ChinaQMTECH/QM_XC7A100T_WUKONG_BOARD/V3/Datasheet/CH340_Windows_Driver/ReadMe.txt

Latest CH340/CH341 driver can be found here: http://www.wch-ic.com/downloads/CH341SER_EXE.html
