ChinaQMTECH/QM_XC7A100T_WUKONG_BOARD/V3/User_Manual/XC7A100T/QMTECH_Artix-7_XC7A100T_Wukong_Board_V3_User_Manual(Experiments)-V01.pdf

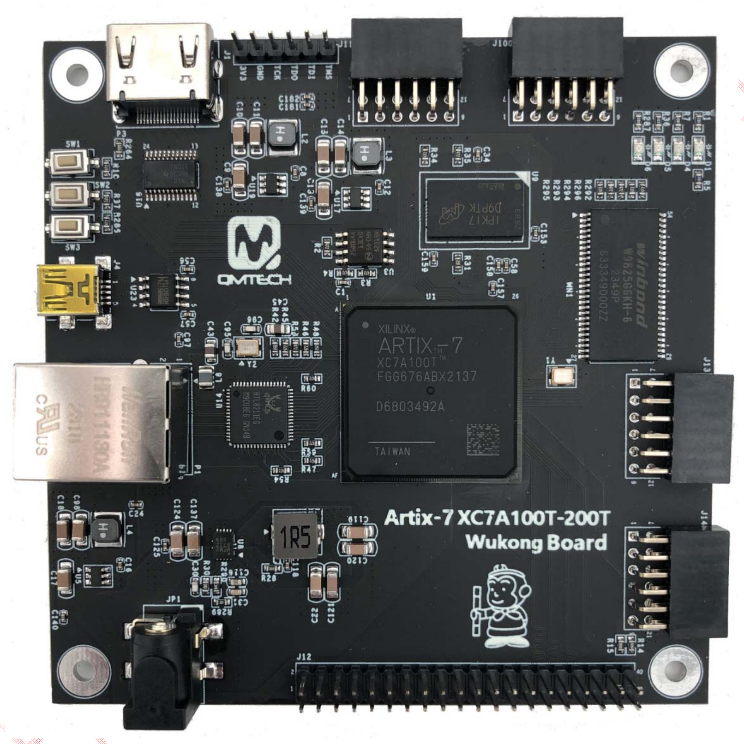
[picture p1: figure]

QMTECH Artix-7 XC7A100T Wukong Board User Manual(Experiments)

# QMTECH ARTIX-7 XC7A100T WUKONG BOARD

## USER MANUAL(EXPERIMENTS)

### Preface

The QMTech® XC7A100T Wukong Board uses Xilinx Artix®-7 devices to demonstrate the highest performance-per-watt fabric, transceiver line rates, DSP processing, and AMS integration in a cost-optimized FPGA. Featuring the MicroBlaze™ soft processor and 1,066Mb/s DDR3 support, the family is the best value for a variety of cost and power-sensitive applications including software-defined radio, machine vision cameras, and low-end wireless backhaul.

QMTECH XC7A100T Wukong Board | User Manual-V01

### Table of Contents

## 1. QMTECH XC7A100T Wukong Board Introduction

### 1.1 Wukong Board Overview

QMTECH XC7A100T Wukong board provides several user interfaces to meet different customer needs. Below section lists the detailed info of these user interfaces:
- USB to UART Serial Port, by using WCH’s CH340N chip.
- HDMI display interface, by using TI’s chip TPD12S016;
- GMII ethernet interface, by using Realtek’s RTL8211EG chip;
- Four Digilent PMOD standard compatible female headers;

### 1.2 Wukong Board Top View

Below figure shows the top view of QMTECH XC7A100T Wukong Board. The board’s dimension is 9.96mm x 9.96mm. All these functional chips’ power supply is injected from the power header, detailed connection refer to the hardware schematic.

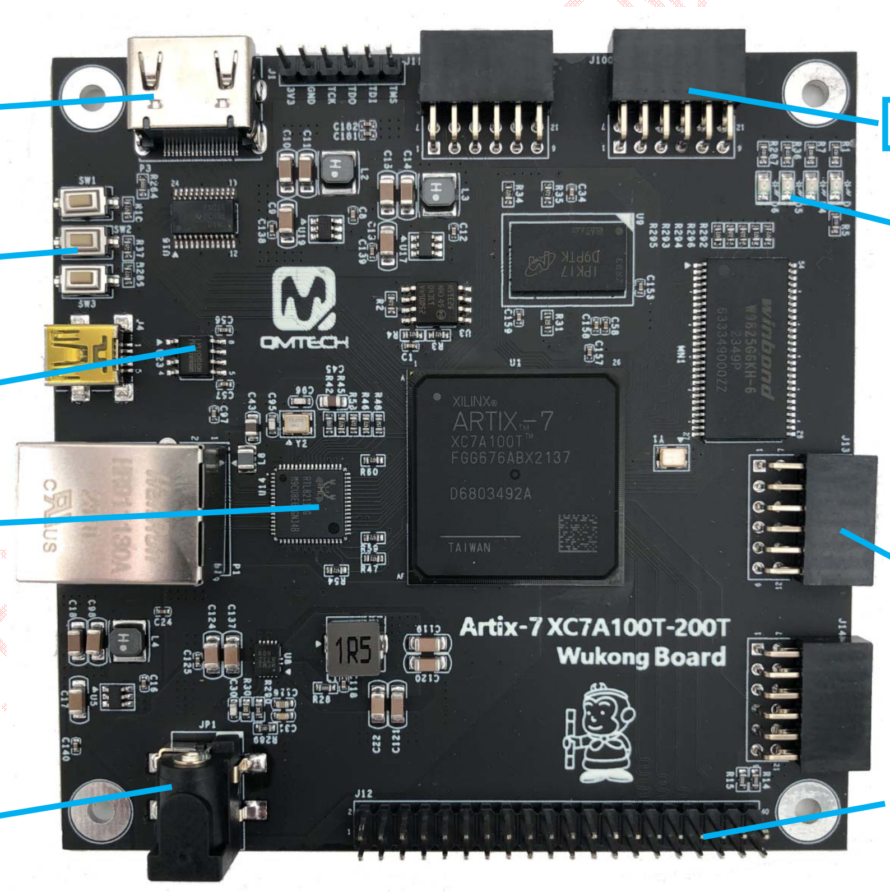
[picture p2: figure]

Figure 1-1. QMTECH XC7A100T Wukong Board

CH340N USB
to UART

HDMI
Interface

GMII
Ethernet

Power
Header

PMOD

User Keys

User IOs

PMOD

User LEDs

## 2. Experiment (1): USB to Serial Port

The CH340N is a USB 2.0 to serial port bridge chip designed by WCH. The CH340N includes a USB 2.0 full-speed function controller, USB transceiver, oscillator, UART and eliminates the need for other external USB components are required for development. Below figure shows the hardware design of CH340N on the QMTECH XC7A100T Wukong board.

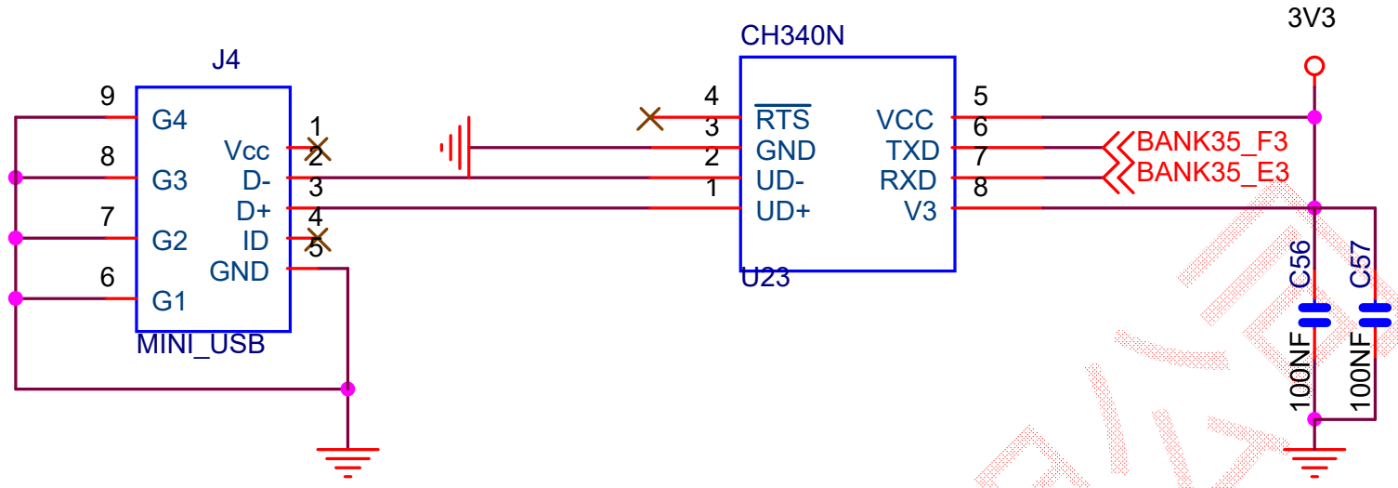
[picture p3: figure]
2 GND; 3 RTS; VCC; TXD; RXD; 3V3C⁵⁶ 100NF; BANK35_F3 BANK35_E3; MINI_USB; Vcc; GND

Figure 2-1. CH340N Hardware Design Before start to test the CH340N’s USB to UART serial communication function, make sure all the hardware connections of the development kit are correctly connected. Xilinx USB platform cable’s VREF, GND, TDI, TMS, TCK, TDO pins shall be connected to XC7A100T board’s JTAG interface. Then power on the development kit with 5V DC power source. Xilinx USB platform cable’s indicator LED’s color will turn from brown into green. At the same time, the Mini-USB cable shall also be plugged in the board, below figure shows an example hardware setup:

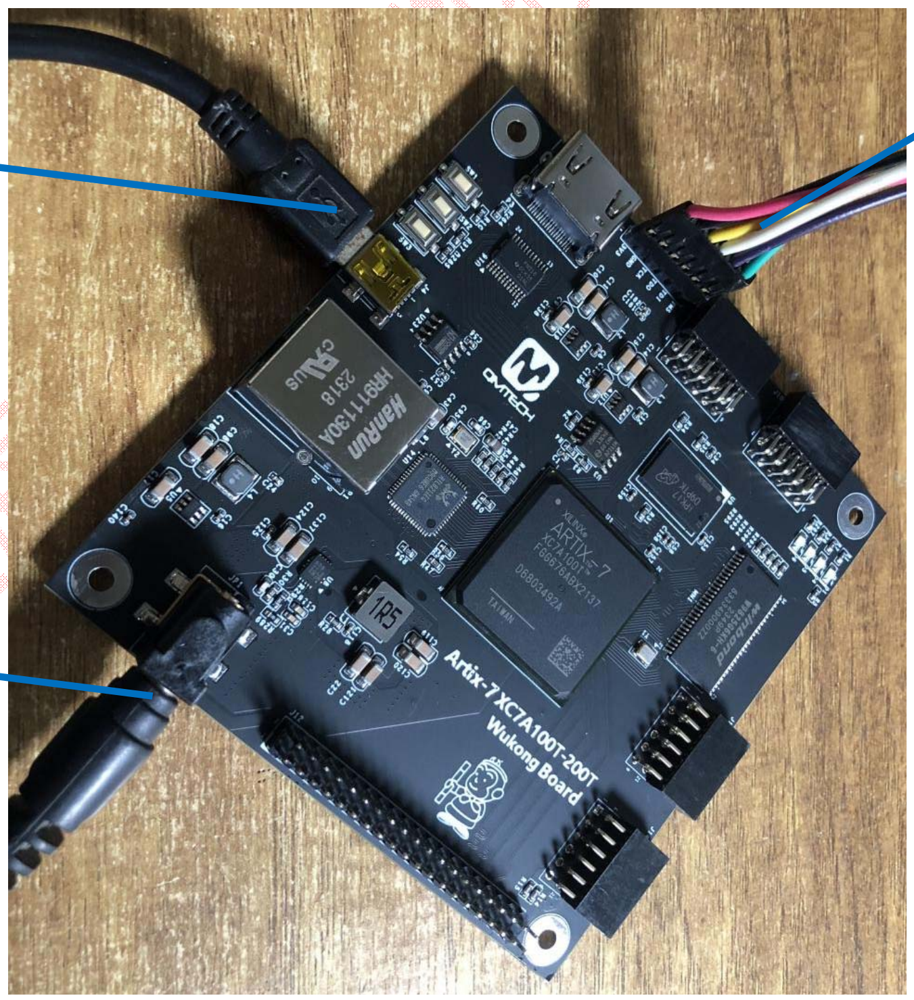
[picture p4: figure]

Mini-USB Cable

5V DC Source

JTAG Cable

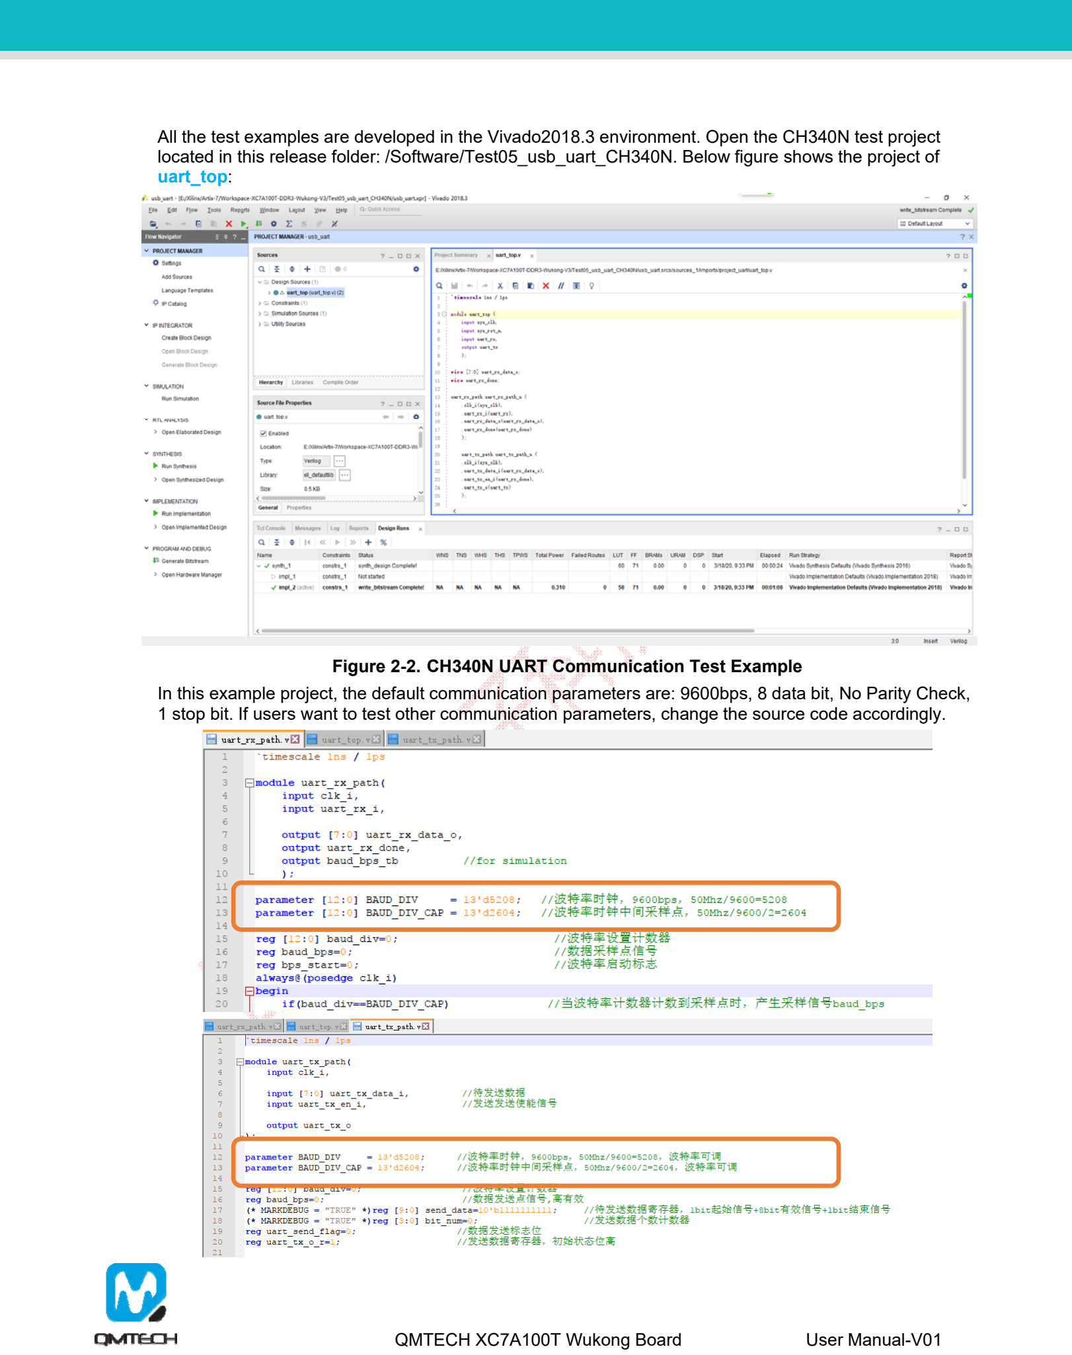
[picture p5: page 5]

All the test examples are developed in the Vivado2018.3 environment. Open the CH340N test project located in this release folder: /Software/Test05_usb_uart_CH340N. Below figure shows the project of uart_top:

Figure 2-2. CH340N UART Communication Test Example In this example project, the default communication parameters are: 9600bps, 8 data bit, No Parity Check, 1 stop bit. If users want to test other communication parameters, change the source code accordingly.

After the CH340N communication test project correctly synthesized, implemented and generated *.bit file, users could use Vivado 2018.3 program tool to program the generated *.bit file into FPGA. Below image shows the FPGA program status with program tool.

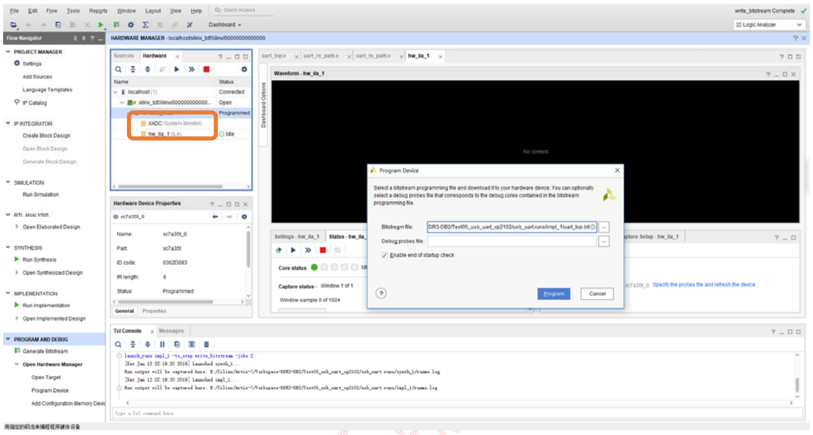
[picture p6: figure]

Figure 2-3. Program *.bit File The CH340N example test project’s main functionality is performing an UART loopback communication. The FPGA program will send the received UART data back to the PC. Below figure shows user employees some PC based UART test tool to send data to FPGA: http://www.cmsoft.cn QQ:10865600. After a short while the PC UART test tool will receive the same data stream from FPGA, which means the CH340N loopback test program is running correctly.

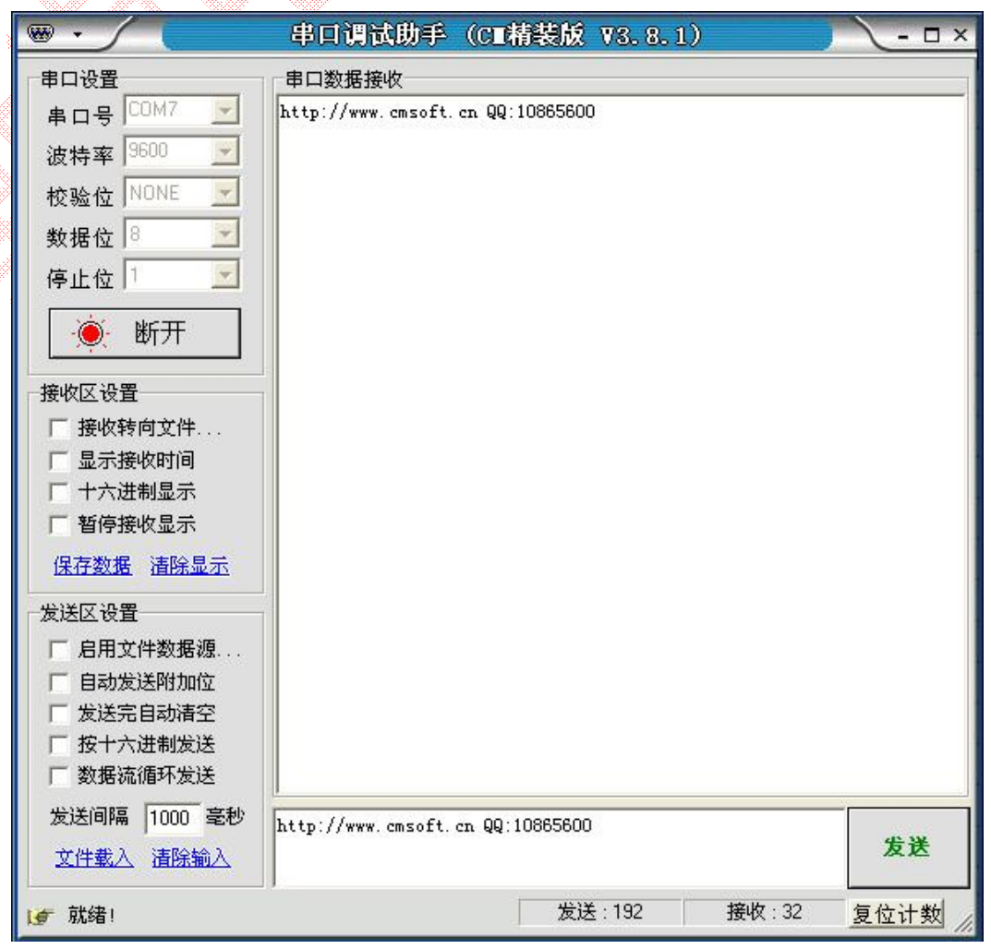
[picture p7: figure]

Figure 2-4. UART Loopback Test

## 3. Experiment (2): HDMI Displays

Transition Minimized Differential Signaling (TMDS) is used for transmitting video data over the High-Definition Multimedia Interface (HDMI). The XC7A100T Wukong Board uses TI’s TPD12S016 chip, which is a single-chip High Definition Multimedia Interface (HDMI) device with auto-direction sensing I2C voltage level shift buffers, a load switch, and integrated low capacitance high-speed electrostatic discharge (ESD) transient voltage suppression (TVS) protection diodes. Below image shows the hardware design.

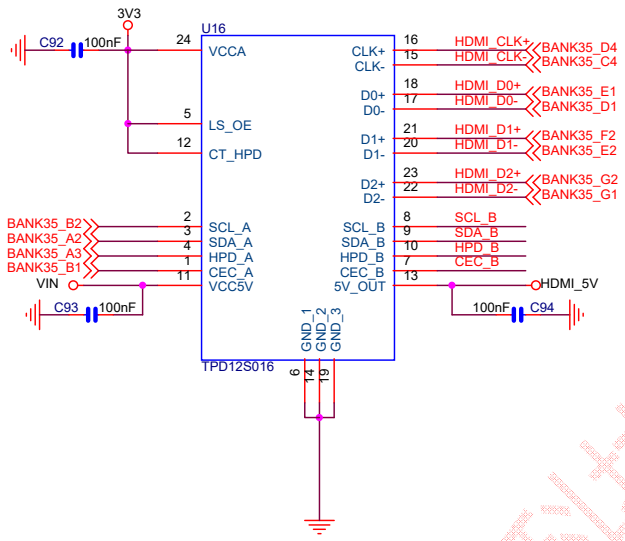
[picture p8: figure]
BANK35_A3; BANK35_A2; BANK35_B2; BANK35_B1; BANK35_C4; BANK35_D4; BANK35_E1 BANK35_D1; BANK35_F2 BANK35_E2; BANK35_G2 BANK35_G1; TPD12S016; CEC_A 1; SCL_A 2 SDA_A 3 HPD_A 4; GND_1 6; CEC_B; SCL_B; SDA_B; HPD_B; VCC5V 11; CT_HPD 12; 5V_OUT 13; GND_2; CLK-; CLK+; GND_3; VCCA 24; VIN; HPD_B CEC_B; HDMI_D1+ HDMI_D1-; HDMI_D2+ HDMI_D2-; SCL_B SDA_B; HDMI_5V; HDMI_CLK+ HDMI_CLK-; HDMI_D0+ HDMI_D0-
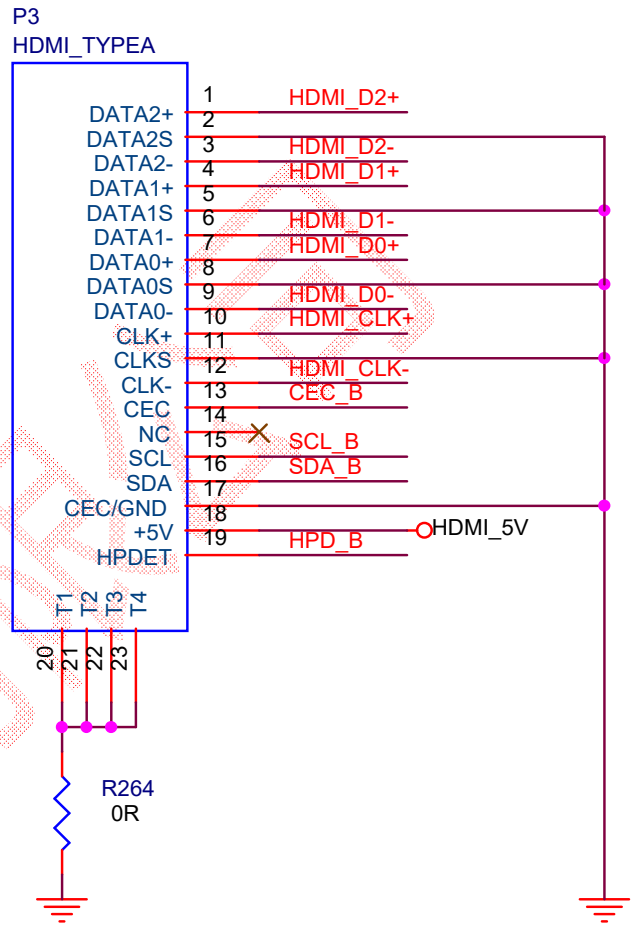
[picture p9: figure]
P3 HDMI_TYPEA; DATA2+ 1 DATA2S 2 DATA2- 3 DATA1+ 4 DATA1S 5 DATA1- 6 DATA0+ 7 DATA0S 8 DATA0- 9 CLK+ 10; CLKS; CLK-; CEC; SCL; SDA; CEC/GND; HPDET; HDMI_5V; CEC_B; SCL_B SDA_B; HPD_B; HDMI_D1- HDMI_D0+; HDMI_D0- HDMI_CLK+; HDMI_CLK-; HDMI_D2+; HDMI_D2- HDMI_D1+

Figure 3-1. HDMI Display Hardware Designs Before start to test the HDMI display function, make sure all the hardware connections of the development kit are correctly connected. Xilinx USB platform cable’s VREF, GND, TDI, TMS, TCK, TDO pins shall be connected to XC7A100T board’s JTAG interface. Then power on the development kit with 5V DC power source. Xilinx USB platform cable’s indicator LED’s color will turn from brown into green. At the same time, the HDMI cable shall also be plugged in the board, below figure shows an example hardware setup:

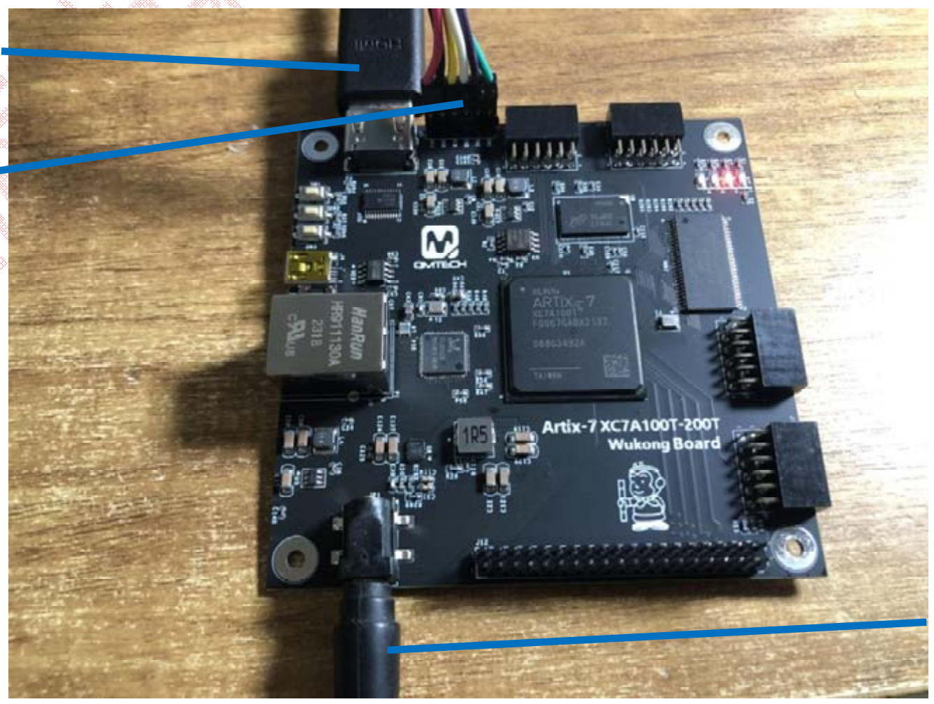
[picture p10: figure]

HDMI Cable

5V DC Source

JTAG Cable

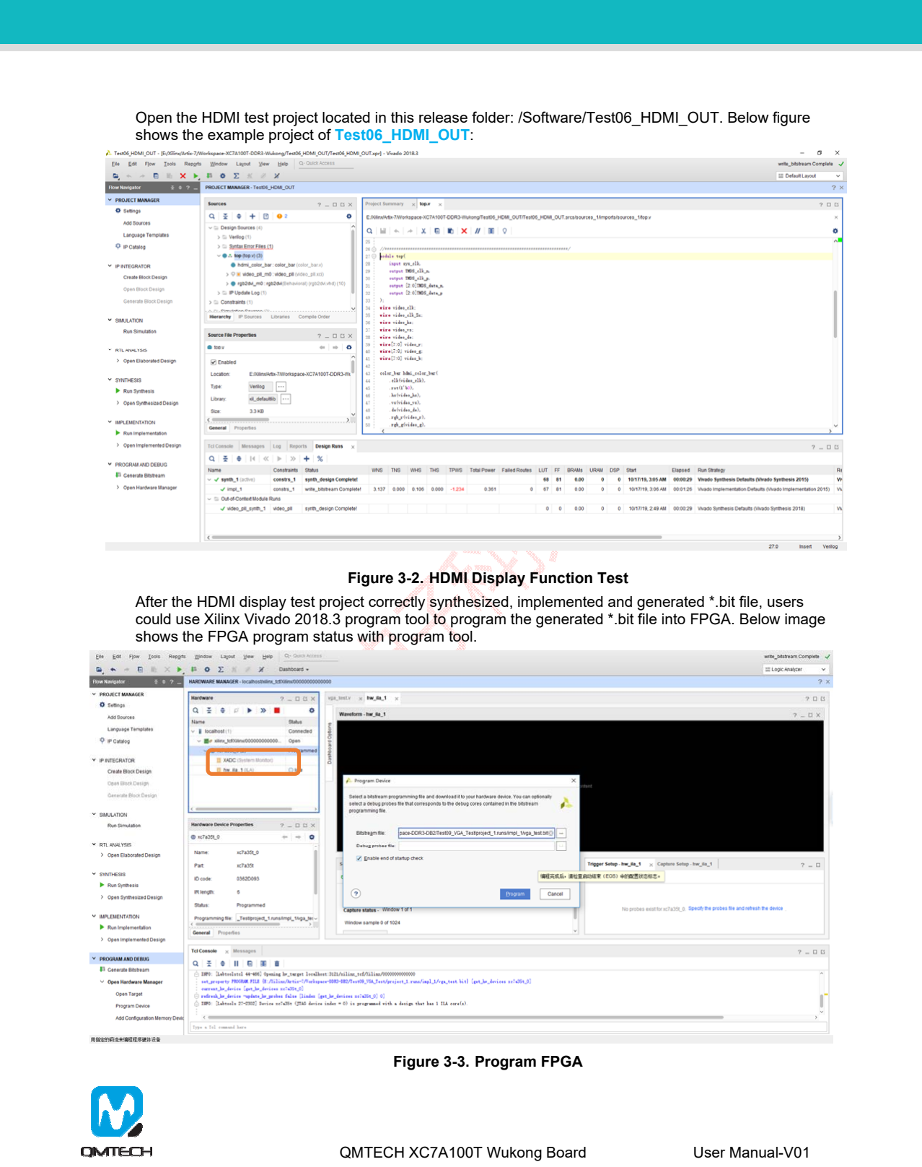
[picture p11: page 8]

Open the HDMI test project located in this release folder: /Software/Test06_HDMI_OUT. Below figure shows the example project of Test06_HDMI_OUT:

Figure 3-2. HDMI Display Function Test After the HDMI display test project correctly synthesized, implemented and generated *.bit file, users could use Xilinx Vivado 2018.3 program tool to program the generated *.bit file into FPGA. Below image shows the FPGA program status with program tool.

Figure 3-3. Program FPGA

After the FPGA correctly loaded the top.bit file, the HDMI monitor will display color bar pattern. Below image shows the example color bar pattern.

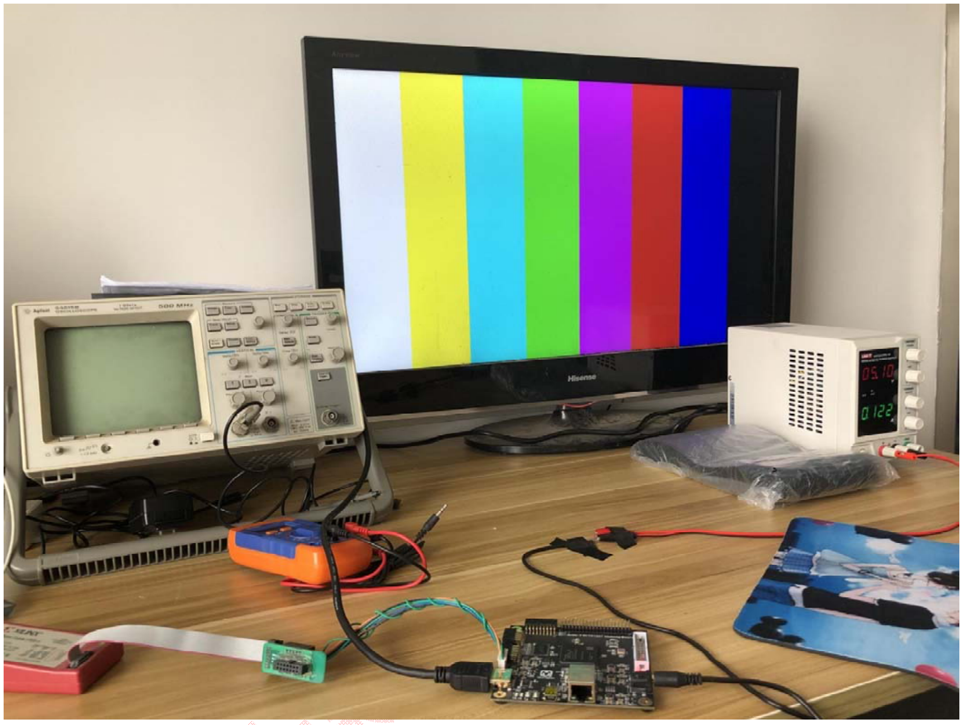
[picture p12: figure]

Figure 3-4. HDMI Display Test

## 4. Experiment (3): GMII Ethernet Test

The XC7A100T board uses RTL8211EG to implement the 10M/100M/1000M triple speed ethernet interface. It provides all the necessary physical layer functions to transmit and receive ethernet packets over the CAT.5 UTP cable. The data transfer between PHY and FPGA is via the Gigabit Media Independent Interface(GMII) for 1000Base-T. The RTL8211EG-VB chip supports 3.3V signaling for GMII interface. Below image shows the hardware design of RTL8211EG:

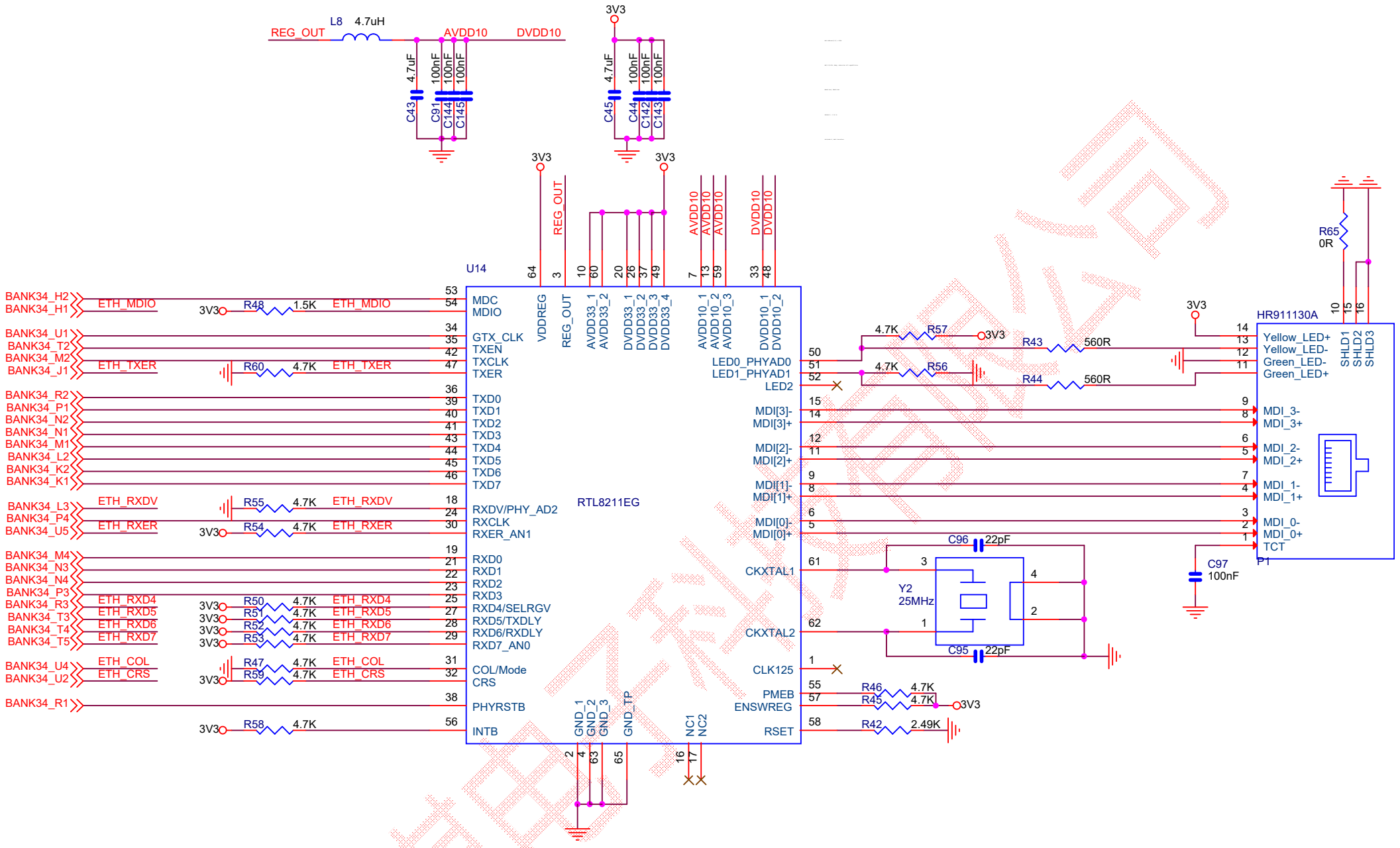
[picture p13: figure]
ETH_RXDV; ETH_RXD4 ETH_RXD5; Y2 25MHz; SHLD1; SHLD2; MDI_0+ 2; MDI_0- 3; MDI_1+ 4; MDI_1- 7; MDI_2+ 5; MDI_2- 6; MDI_3+ 8; MDI_3- 9; SHLD3; TCT 1; RTL8211EG; CLK125; GND_1 2 REG_OUT 3; GND_2 4; MDI[0]+; MDI[0]-; AVDD10_1 7; MDI[1]+; MDI[1]-; AVDD33_1; MDI[2]+; MDI[2]-; AVDD10_2; MDI[3]+; MDI[3]-; RXDV/PHY_AD2 18; RXD0 19; DVDD33_1; RXD1 21 RXD2 22 RXD3 23; RXCLK 24; RXD4/SELRGV 25; DVDD33_2; RXD5/TXDLY 27 RXD6/RXDLY 28 RXD7_AN0 29; RXER_AN1 30; COL/Mode 31 CRS 32; DVDD10_1; GTX_CLK 34 TXEN 35; TXD0 36; DVDD33_3; PHYRSTB 38; TXD1 39 TXD2 40 TXD3 41; TXCLK 42; TXD4 43 TXD5 44 TXD6 45 TXD7 46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

Green_LED+ 11 Green_LED- 12 Yellow_LED- 13 Yellow_LED+ 14

Figure 4-1. RTL8211 Hardware Design Before start to test the GMII ethernet communication function, make sure all the hardware connections of the development kit are correctly connected. Xilinx USB Platform cable shall be connected to XC7A100T board’s JTAG interface. The ethernet cable shall be plugged in the board and the test computer simultaneously. Then power on the development kit with 5V DC power source. Below figure shows an example hardware setup:

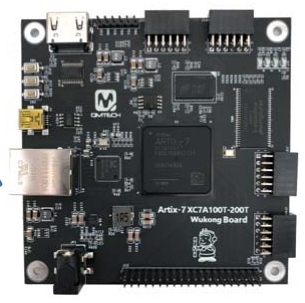
[picture p14: figure]
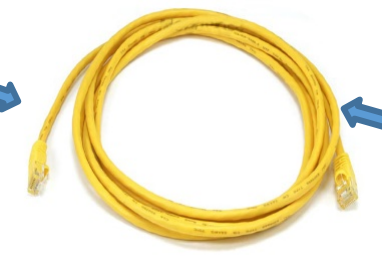
[picture p15: figure]
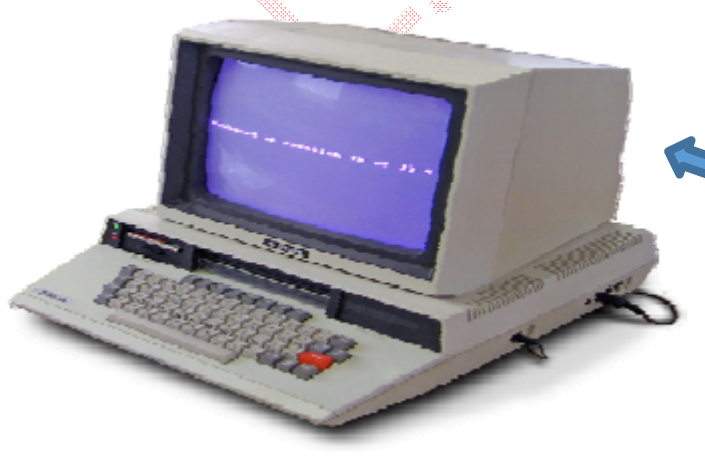
[picture p16: figure]
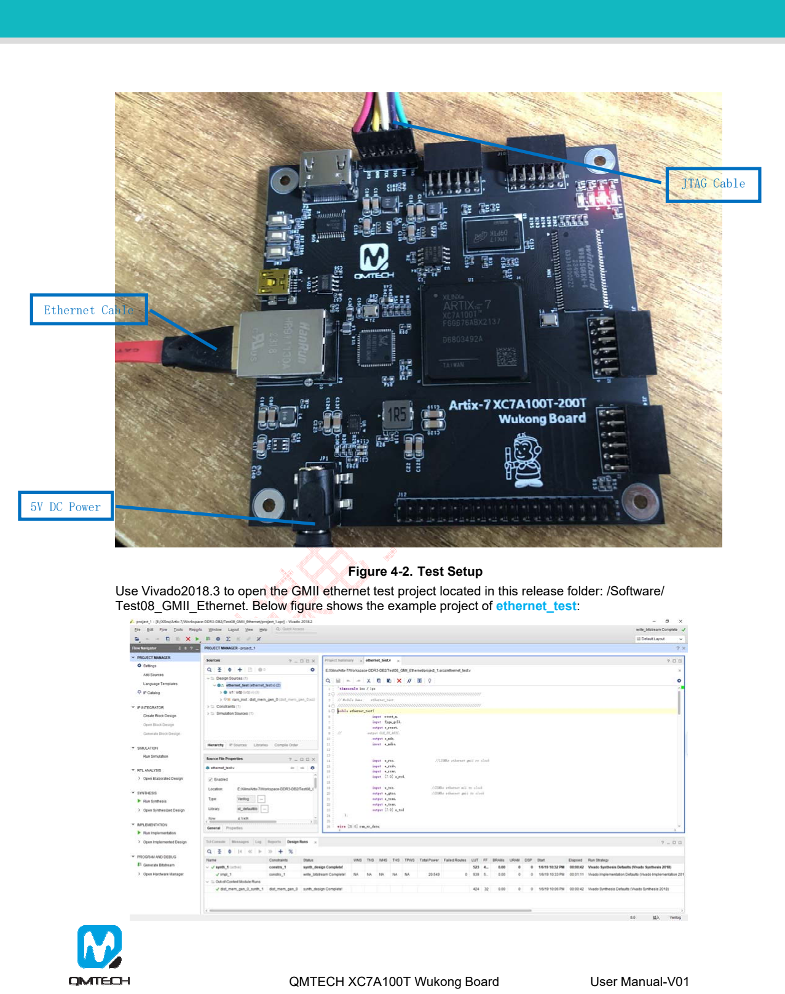
[picture p17: page 11]

Figure 4-2. Test Setup
Use Vivado2018.3 to open the GMII ethernet test project located in this release folder: /Software/ Test08_GMII_Ethernet. Below figure shows the example project of ethernet_test:

JTAG Cable

5V DC Power

Ethernet Cable

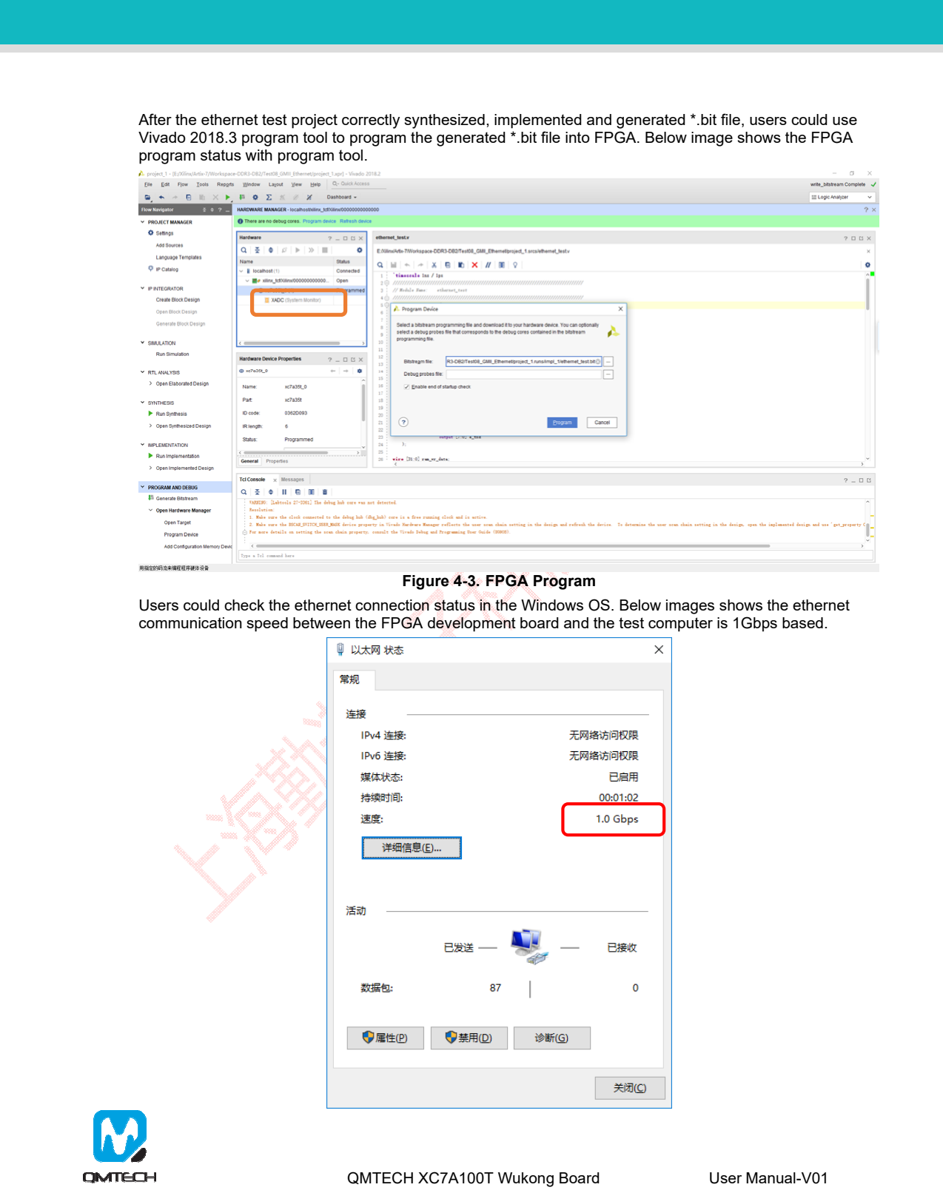
[picture p18: page 12]

After the ethernet test project correctly synthesized, implemented and generated *.bit file, users could use Vivado 2018.3 program tool to program the generated *.bit file into FPGA. Below image shows the FPGA program status with program tool.

Figure 4-3. FPGA Program
Users could check the ethernet connection status in the Windows OS. Below images shows the ethernet communication speed between the FPGA development board and the test computer is 1Gbps based.

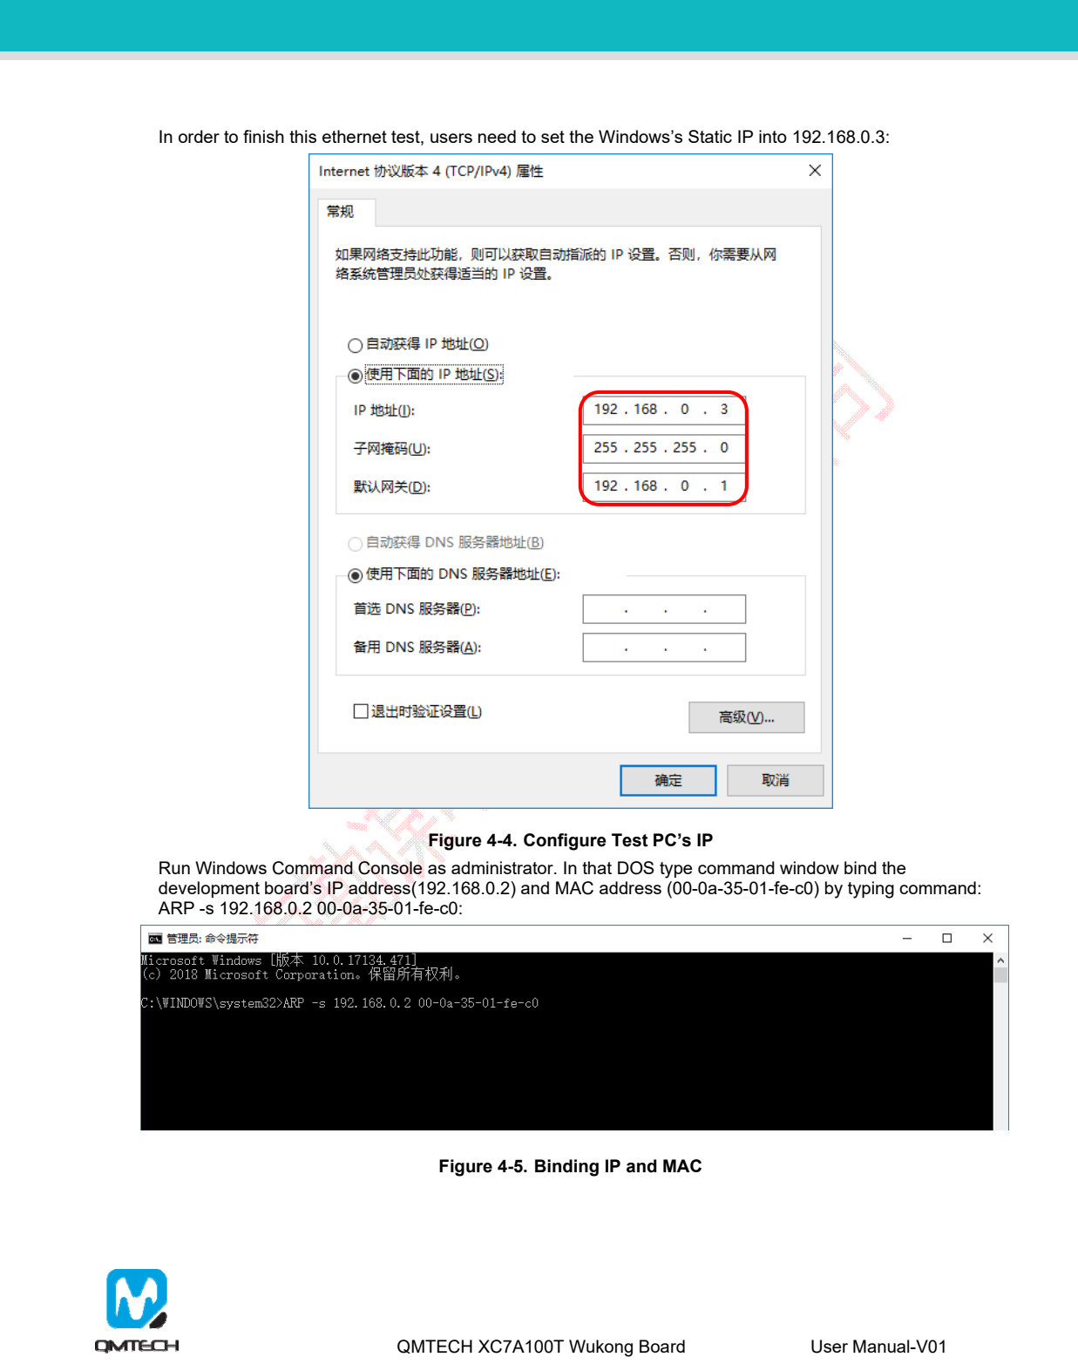
[picture p19: page 13]

In order to finish this ethernet test, users need to set the Windows’s Static IP into 192.168.0.3:

Figure 4-4. Configure Test PC’s IP Run Windows Command Console as administrator. In that DOS type command window bind the development board’s IP address(192.168.0.2) and MAC address (00-0a-35-01-fe-c0) by typing command: ARP -s 192.168.0.2 00-0a-35-01-fe-c0:

Figure 4-5. Binding IP and MAC

Open the NetAssist ethernet debug tool and set the communication parameters as shown in below figure. The NetAssist tool will receive the test data “HELLO QMTECH BOARD” sent from development board. Then press the【Send】button to send the test data http://www.cmsoft.cn QQ:10865600 to the FPGA development board. In response, the FPGA will send back test data to the test PC.

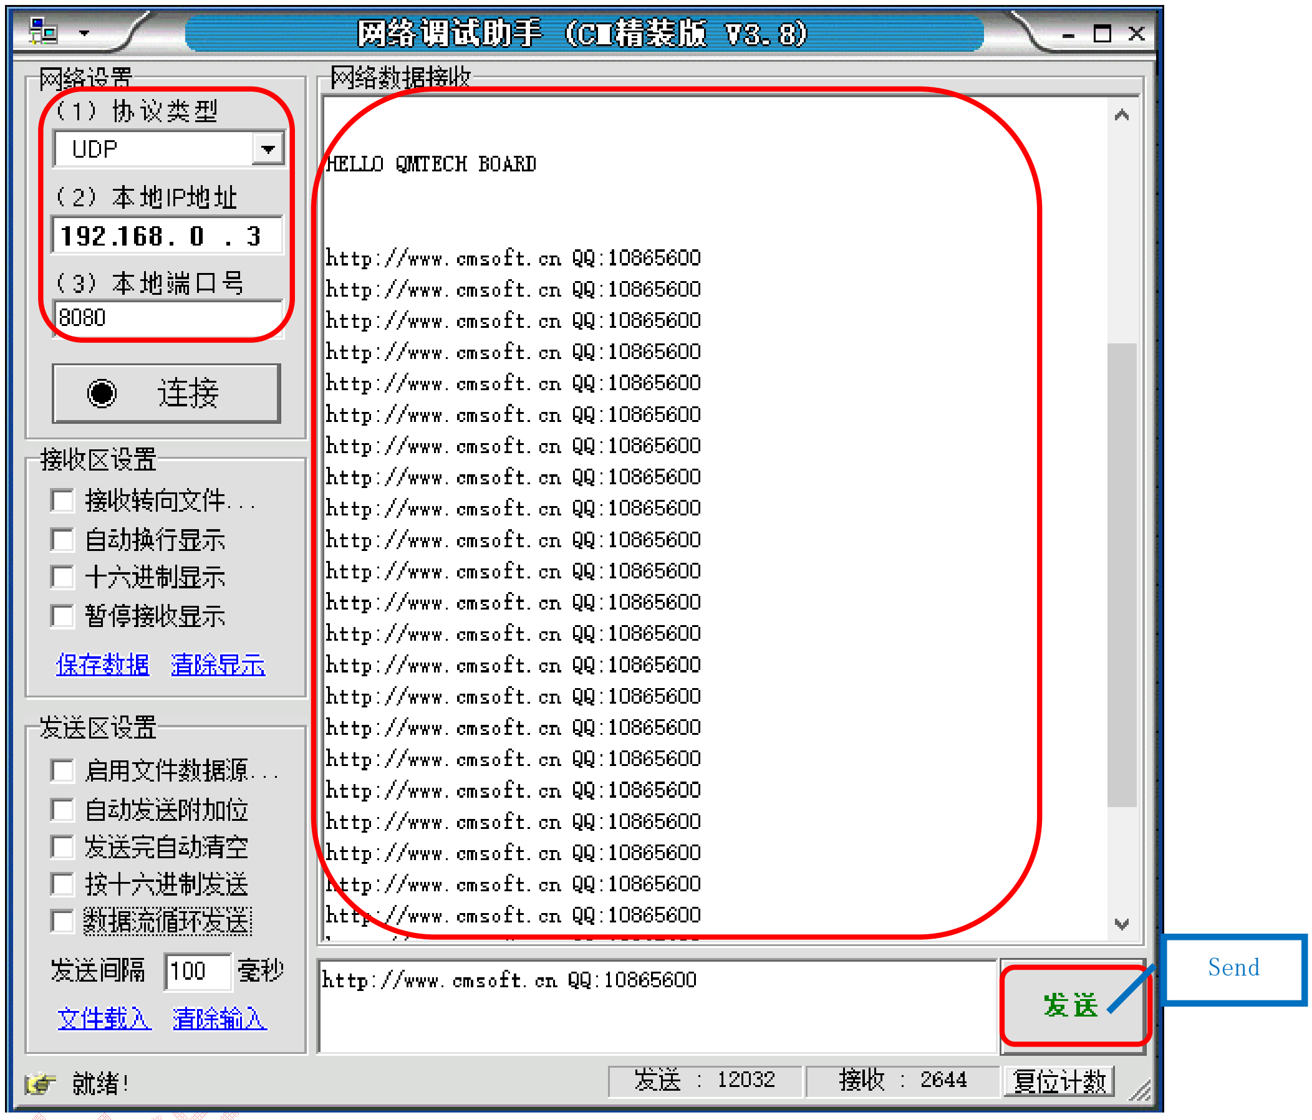
[picture p20: figure]
Send

Figure 4-6. GMII Ethernet Test Result

## 5. Reference

[1] ug470_7Series_Config.pdf
[2] ds181_Artix_7_Data_Sheet.pdf
[3] ug475_7Series_Pkg_Pinout.pdf
[4] n25q_64a_3v_65nm.pdf
[5] MT41J128M16JT-125K.pdf

## 6. Revision

Doc. Rev. | Date | Comments
0.1 | 21/04/2021 | Initial Version.
1.0 | 26/04/2021 | V1.0 Formal Release.
1.0 | 28/01/2024 | V1.0 Formal Release for Wukong Board V3.
