ChinaQMTECH/QM_XC7A100T_WUKONG_BOARD/V3/User_Manual/XC7A100T/QMTECH_Artix-7_XC7A100T_Wukong_Board_V3_User_Manual(Hardware)_V01.pdf

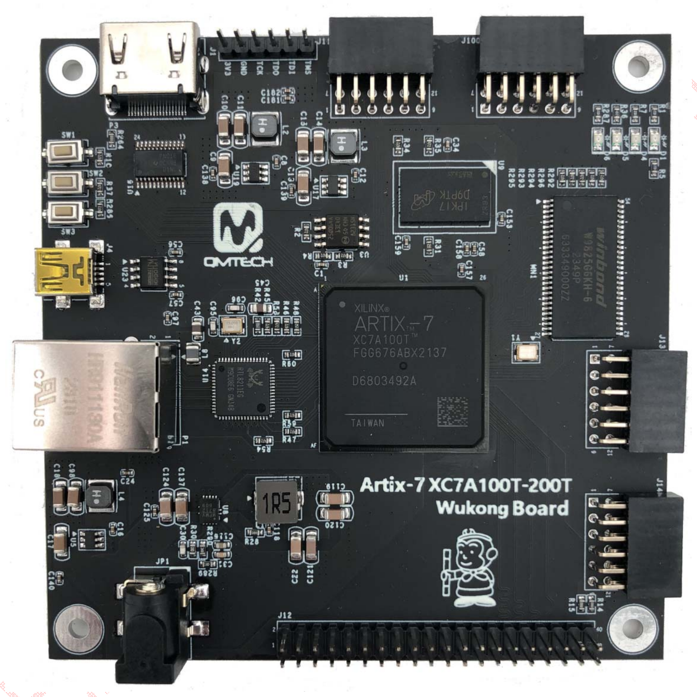
[picture p21: figure]

QMTECH XC7A100T Wukong Board | User Manual V01

# QMTECH ARTIX-7 XC7A100T WUKONG BOARD

## HARDWARE USER MANUAL

### Preface

The QMTech® XC7A100T Wukong Board uses Xilinx Artix®-7 devices to demonstrate the highest performance-per-watt fabric, transceiver line rates, DSP processing, and AMS integration in a cost optimized FPGA. Featuring the MicroBlaze™ soft processor and 1,066Mb/s DDR3 support, the family is the best value for a variety of cost and power-sensitive applications including software-defined radio, machine vision cameras, and low-end wireless backhaul.

### Table of Contents

## 1. Introduction

### 1.1 Document Scope

This demo user manual introduces the QMTECH XC7A100T Wukong board and describes how to setup the board running with application software Xilinx Vivado 2018.3. Users may employee the on board rich logic resource FPGA XC7A100T-1FGG676C and large DDR3 memory MT41K128M16 to implement various applications. The Wukong Board also has many non-multiplexed FPGA IOs for extending customized modules, such as UART module, CMOS/CCD camera module, LCD/HDMI/VGA display module etc.

### 1.2 Kit Overview

Below section lists the parameters of the QMTECH XC7A100T Wukong Board:
- On-Board FPGA: XC7A100T-1FGG676C;
- On-Board FPGA external crystal frequency: 50MHz;
- XC7A100T-1FGG676C has rich block RAM resource up to 4,860Kb;
- XC7A100T-1FGG676C has 101,440 logic cells;
- On-Board N25Q64A SPI Flash, 8M bytes for user configuration code;
- On-Board 256MB Micron DDR3, MT41K128M16JT-125:K;
- On-Board 32MB Winbond SDRAM, W9825G6KH-6;
- On-Board core power supply for FPGA by using MP8712 wide input range DC/DC;
- XC7A100T board provides 4 PMOD compatible headers and 40P Male header for User IOs;
- XC7A100T board has 3 user switches;
- XC7A100T board has 4 user LEDs;
- XC7A100T board has one Micro SD Card slot;
- XC7A100T board provides HDMI display interface;
- XC7A100T board has JTAG interface, by using 6p, 2.54mm pitch header;
- XC7A100T board PCB size is: 9.96cm x 9.96cm;
- Default power source for board is: 2A@5V DC, the DC header type: DC-050, 5.5mmx2.1mm;

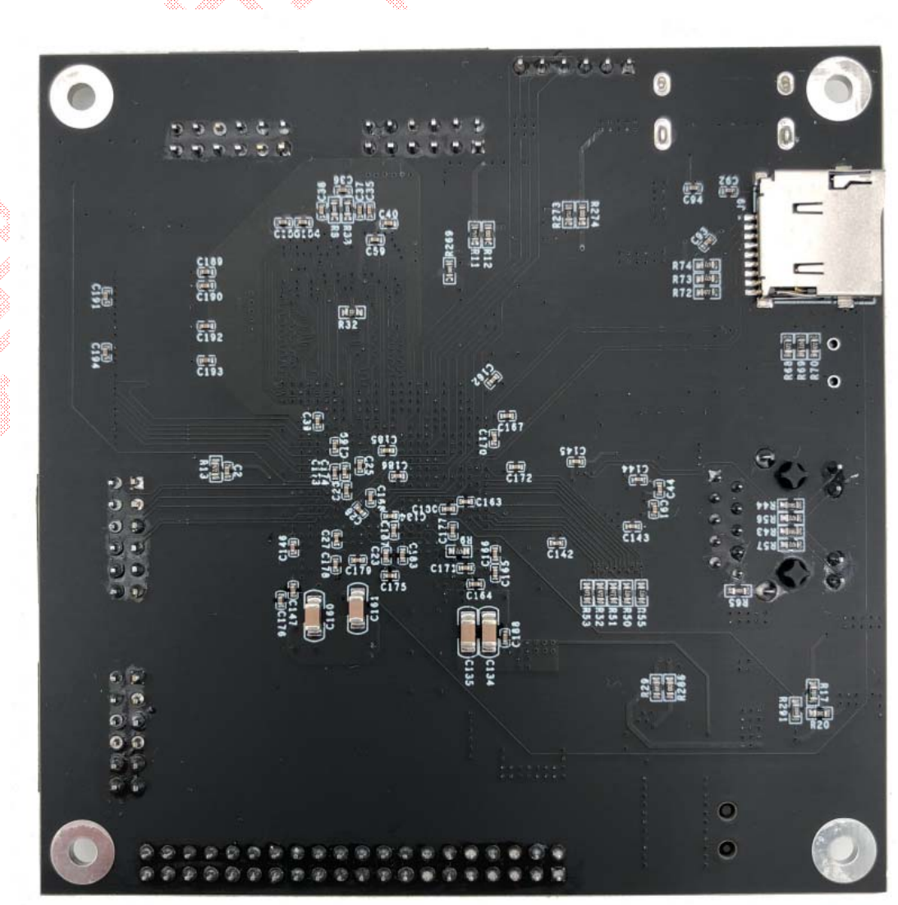
[picture p22: figure]

Figure 1-1. QMTECH XC7A100T Wukong Board Bottom View

## 2. Getting Started

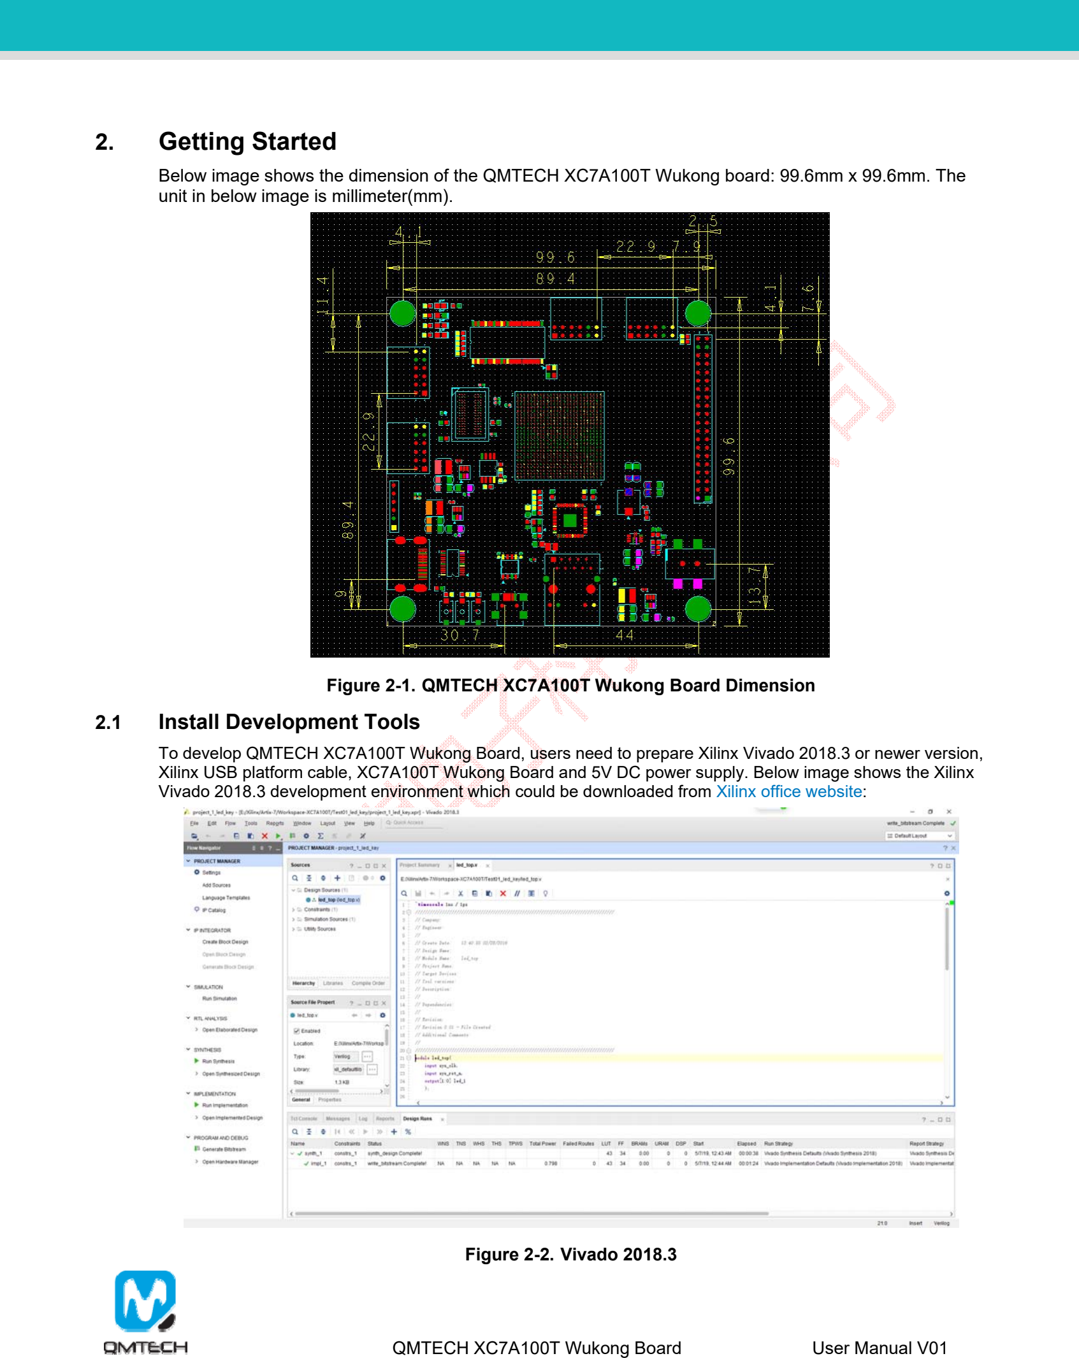
[picture p23: page 4]

Below image shows the dimension of the QMTECH XC7A100T Wukong board: 99.6mm x 99.6mm. The unit in below image is millimeter(mm).

Figure 2-1. QMTECH XC7A100T Wukong Board Dimension

### 2.1 Install Development Tools

To develop QMTECH XC7A100T Wukong Board, users need to prepare Xilinx Vivado 2018.3 or newer version, Xilinx USB platform cable, XC7A100T Wukong Board and 5V DC power supply. Below image shows the Xilinx Vivado 2018.3 development environment which could be downloaded from Xilinx office website:

Figure 2-2. Vivado 2018.3

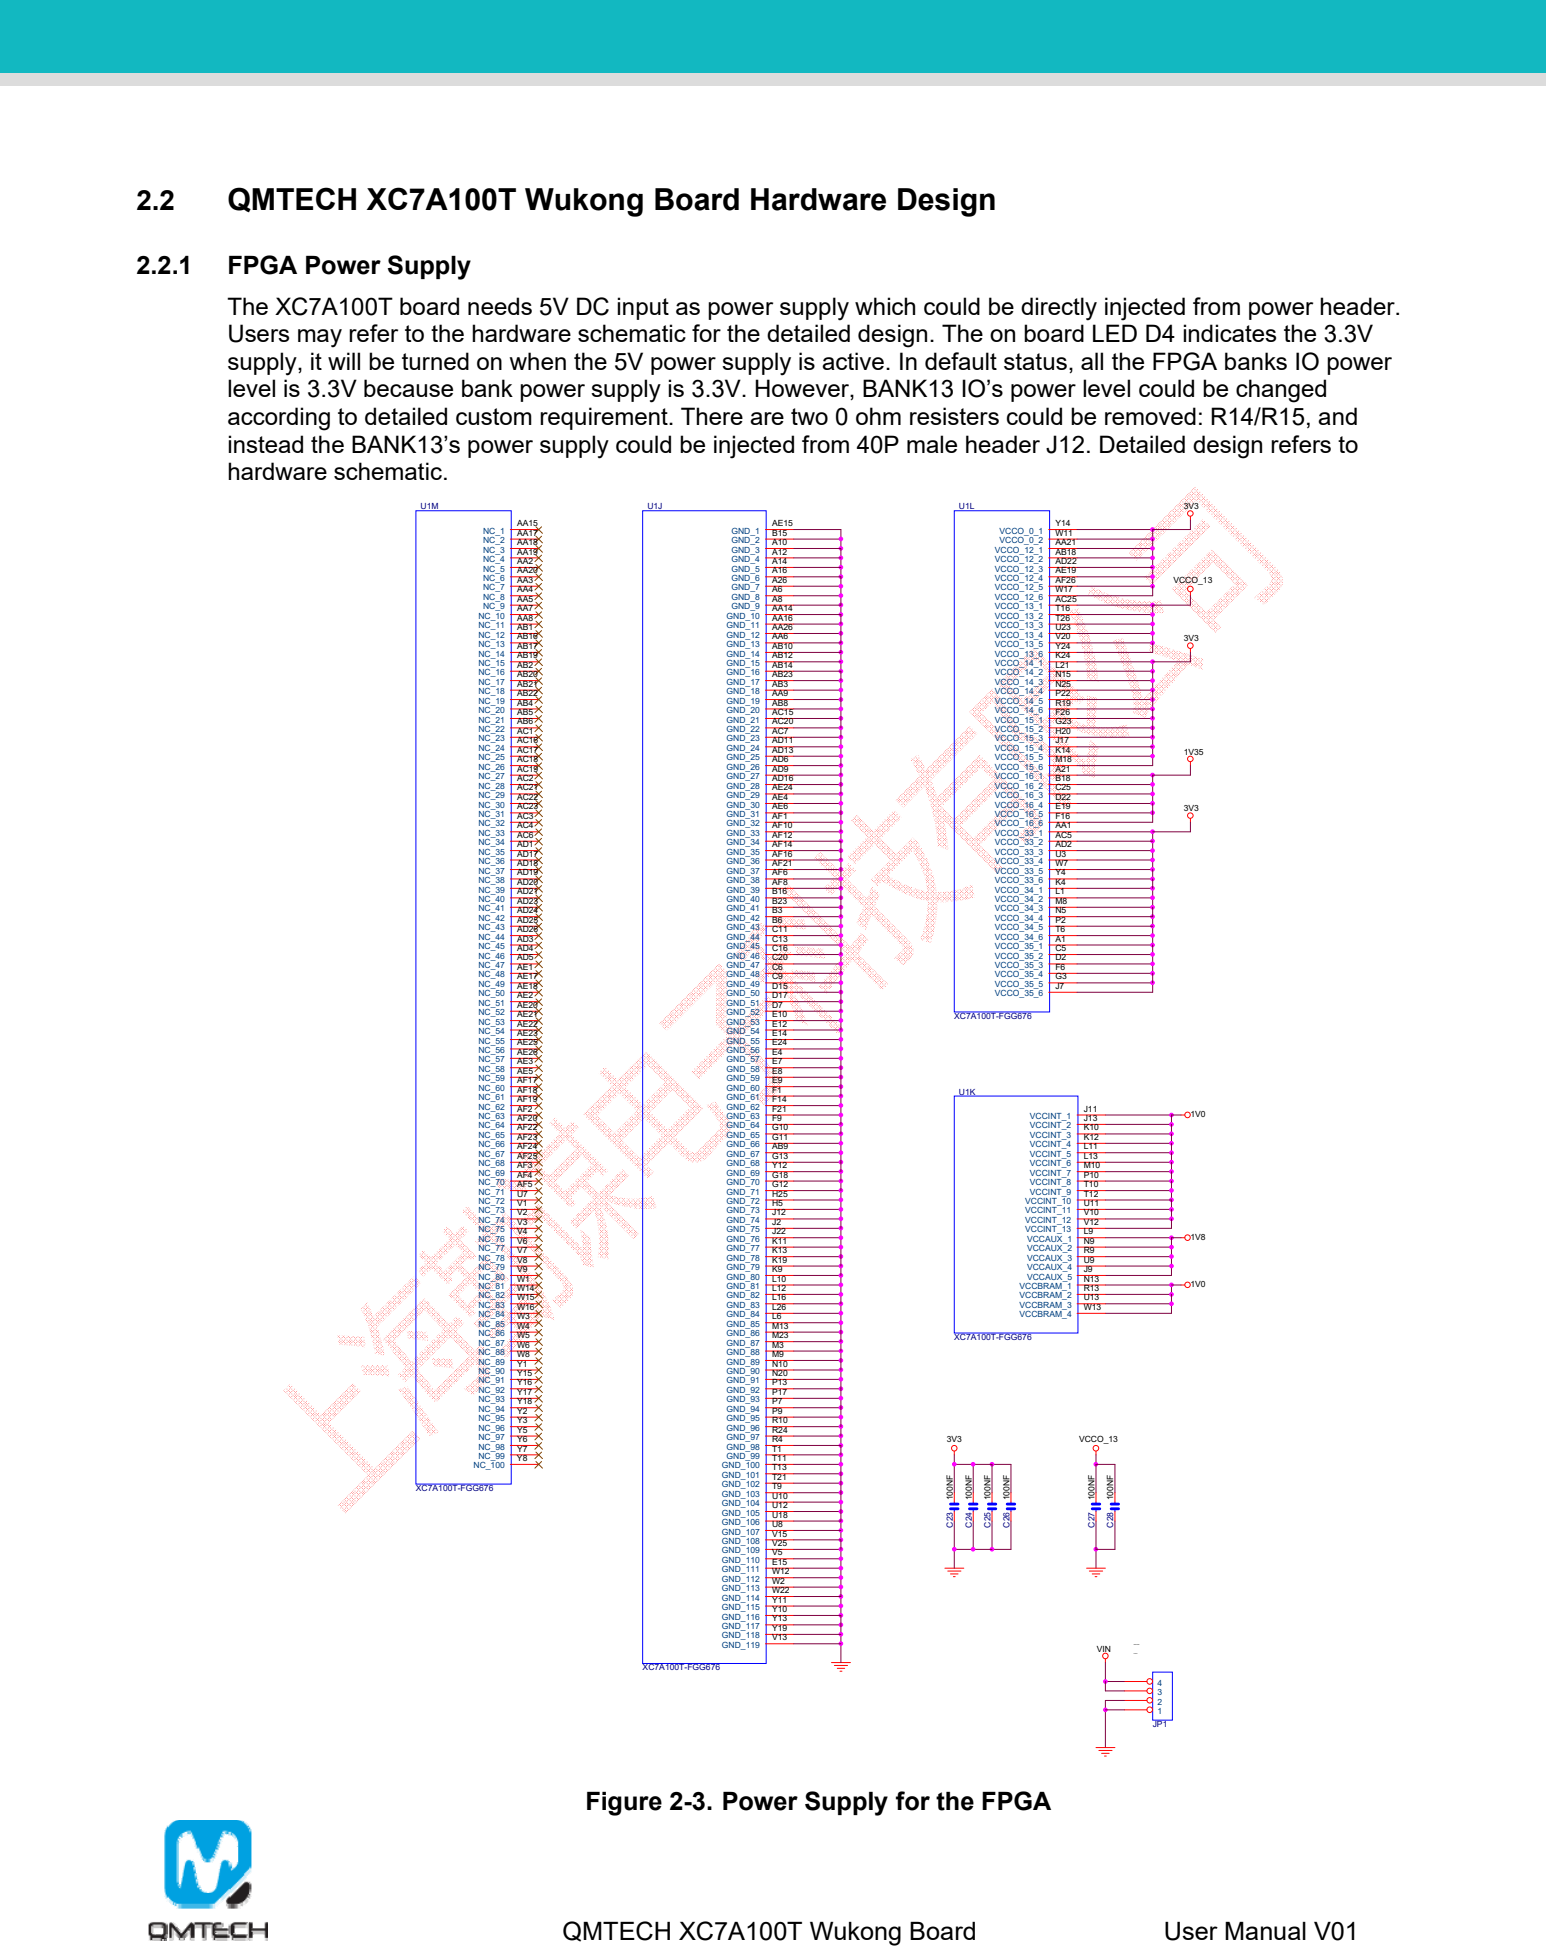
[picture p24: page 5]

2.2 QMTECH XC7A100T Wukong Board Hardware Design

The XC7A100T board needs 5V DC input as power supply which could be directly injected from power header.
Users may refer to the hardware schematic for the detailed design. The on board LED D4 indicates the 3.3V
supply, it will be turned on when the 5V power supply is active. In default status, all the FPGA banks IO power
level is 3.3V because bank power supply is 3.3V. However, BANK13 IO’s power level could be changed
according to detailed custom requirement. There are two 0 ohm resisters could be removed: R14/R15, and
instead the BANK13’s power supply could be injected from 40P male header J12. Detailed design refers to
hardware schematic.

Figure 2-3. Power Supply for the FPGA

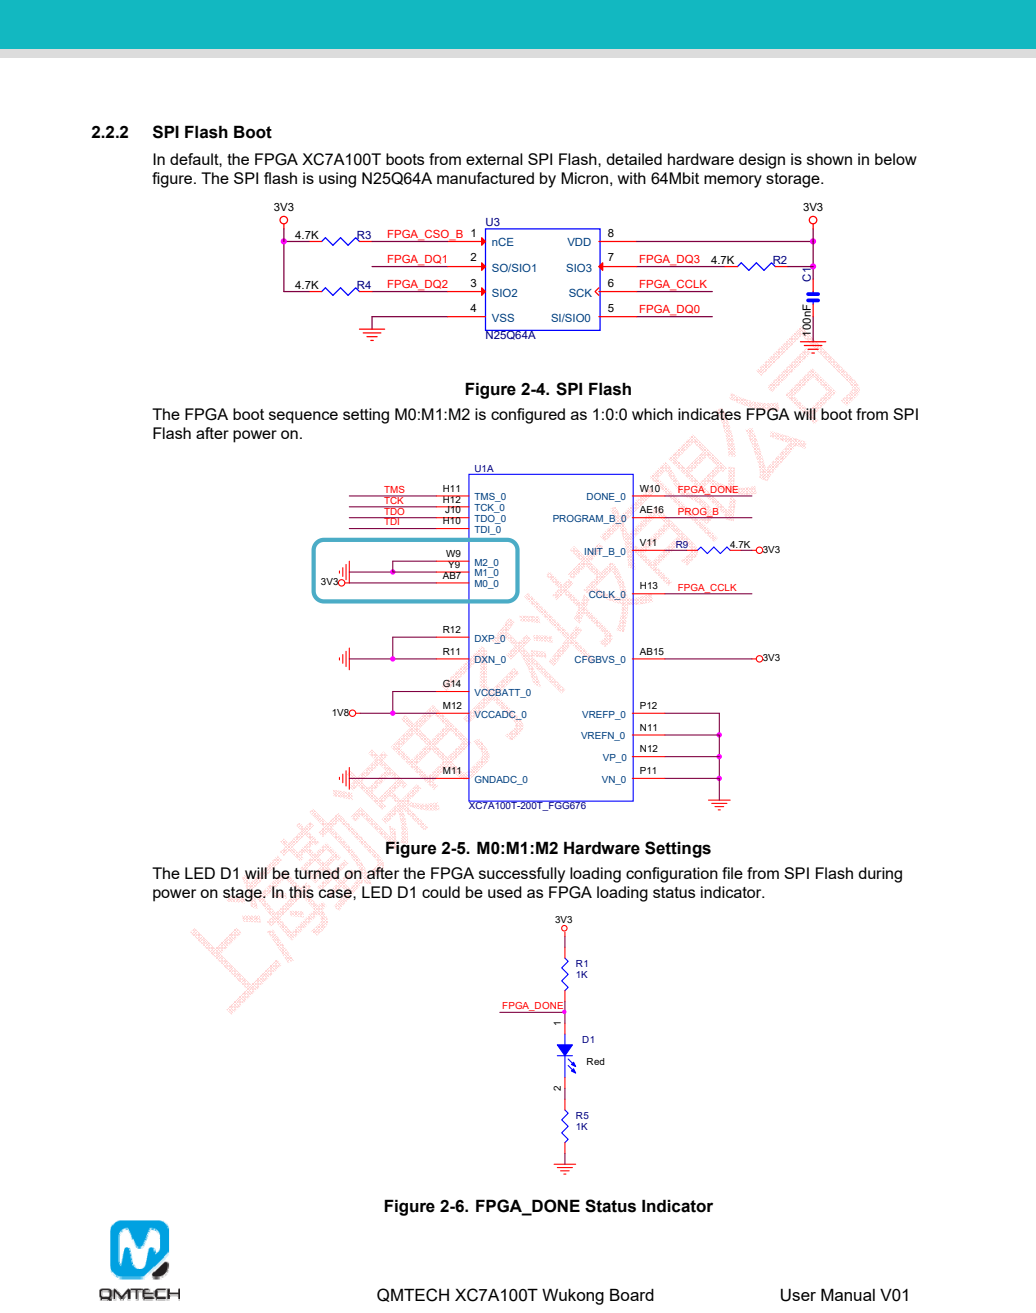
[picture p25: page 6]

In default, the FPGA XC7A100T boots from external SPI Flash, detailed hardware design is shown in below
figure. The SPI flash is using N25Q64A manufactured by Micron, with 64Mbit memory storage.

The FPGA boot sequence setting M0:M1:M2 is configured as 1:0:0 which indicates FPGA will boot from SPI
Flash after power on.

The LED D1 will be turned on after the FPGA successfully loading configuration file from SPI Flash during
power on stage. In this case, LED D1 could be used as FPGA loading status indicator.

### 2.2.3 System Clock

FPGA chip XC7A100T-1FGG676C has system clock frequency 50MHz which is directly provided by external crystal. The crystal is designed with high accuracy and stability with low temperature drift 10ppm/°c. Below image shows the detailed hardware design:

C2
100NF ⁵⁰ MHz

VDD

VSS | OUT

OE

Y1

SG-8002JC-50.0000M-PCB

1 | 4
2 | 3 SYS_CLK
R13 | 4.7K 3V3

Figure 2-7. 50MHz System Clock

### 2.2.4 User Extension IOs

The XC7A100T board has one 40P 2.54mm pitch male header which could be used for extending user modules, such as ADC/DAC module, audio/video module, ethernet module, etc.

VCCO_13 | VCCO_13

VIN

J12

HDR_20X2

1 | 2
3 | 4
5 | 6
7 | 8
9 | 10
11 | 12
13 | 14
15 | 16
17 | 18
19 | 20
21 | 22
23 | 24
25 | 26
27 | 28
29 | 30
31 | 32
33 | 34
35 | 36
37 | 38
39 | 40
BANK13_W25 | BANK13_Y26
BANK13_V26 | BANK13_W26

BANK13_V18

BANK13_W24

BANK13_U26

BANK13_V24

BANK13_W18

BANK13_U14 | BANK13_V14
BANK13_V16 | BANK13_V17
BANK13_U15 | BANK13_U16
BANK13_V19 | BANK13_W19
BANK13_T20 | BANK13_U20

BANK13_U25

BANK13_V22

BANK13_W21 | BANK13_Y21
BANK13_U22
BANK13_V23 | BANK13_W23
BANK13_Y25 | BANK13_AA25
BANK13_AB26 | BANK13_AC26
BANK13_AA24 | BANK13_AB25
BANK13_AB24 | BANK13_AC24

The XC7A100T board has 4 PMOD compatible interfaces.

BANK35_D5 | BANK35_E5
BANK35_G5 | BANK35_E6

BANK35_G8

BANK35_G7
BANK35_G6

BANK35_D6

J10

PMOD

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
3V3 | 3V3
BANK35_A5 | BANK35_B5
BANK35_A4 | BANK35_B4
BANK35_H4 | BANK35_J4
BANK35_F4 | BANK35_G4

J11

PMOD

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
3V3 | 3V3
BANK14_R20 | BANK14_P21
BANK14_T22 | BANK14_R21
BANK14_N22 | BANK14_P20
BANK14_N21 | BANK14_N23

J13

PMOD

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
3V3 | 3V3
BANK14_T25 | BANK14_T23
BANK14_T24 | BANK14_R22 BANK14_P24

BANK14_N24
BANK14_R23

BANK14_P23

J14

PMOD

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
3V3 | 3V3

Figure 2-8. Extension IO

External voltage supply
pins for BANK13.
R14/R15 shall be removed
before apply any voltage
to these two pins.

# design for these power supplies. C¹³⁸ ¹⁰⁰NF C¹³⁹ ¹⁰⁰NF C¹⁴⁰ ¹⁰⁰NF

## MP8712BST 1

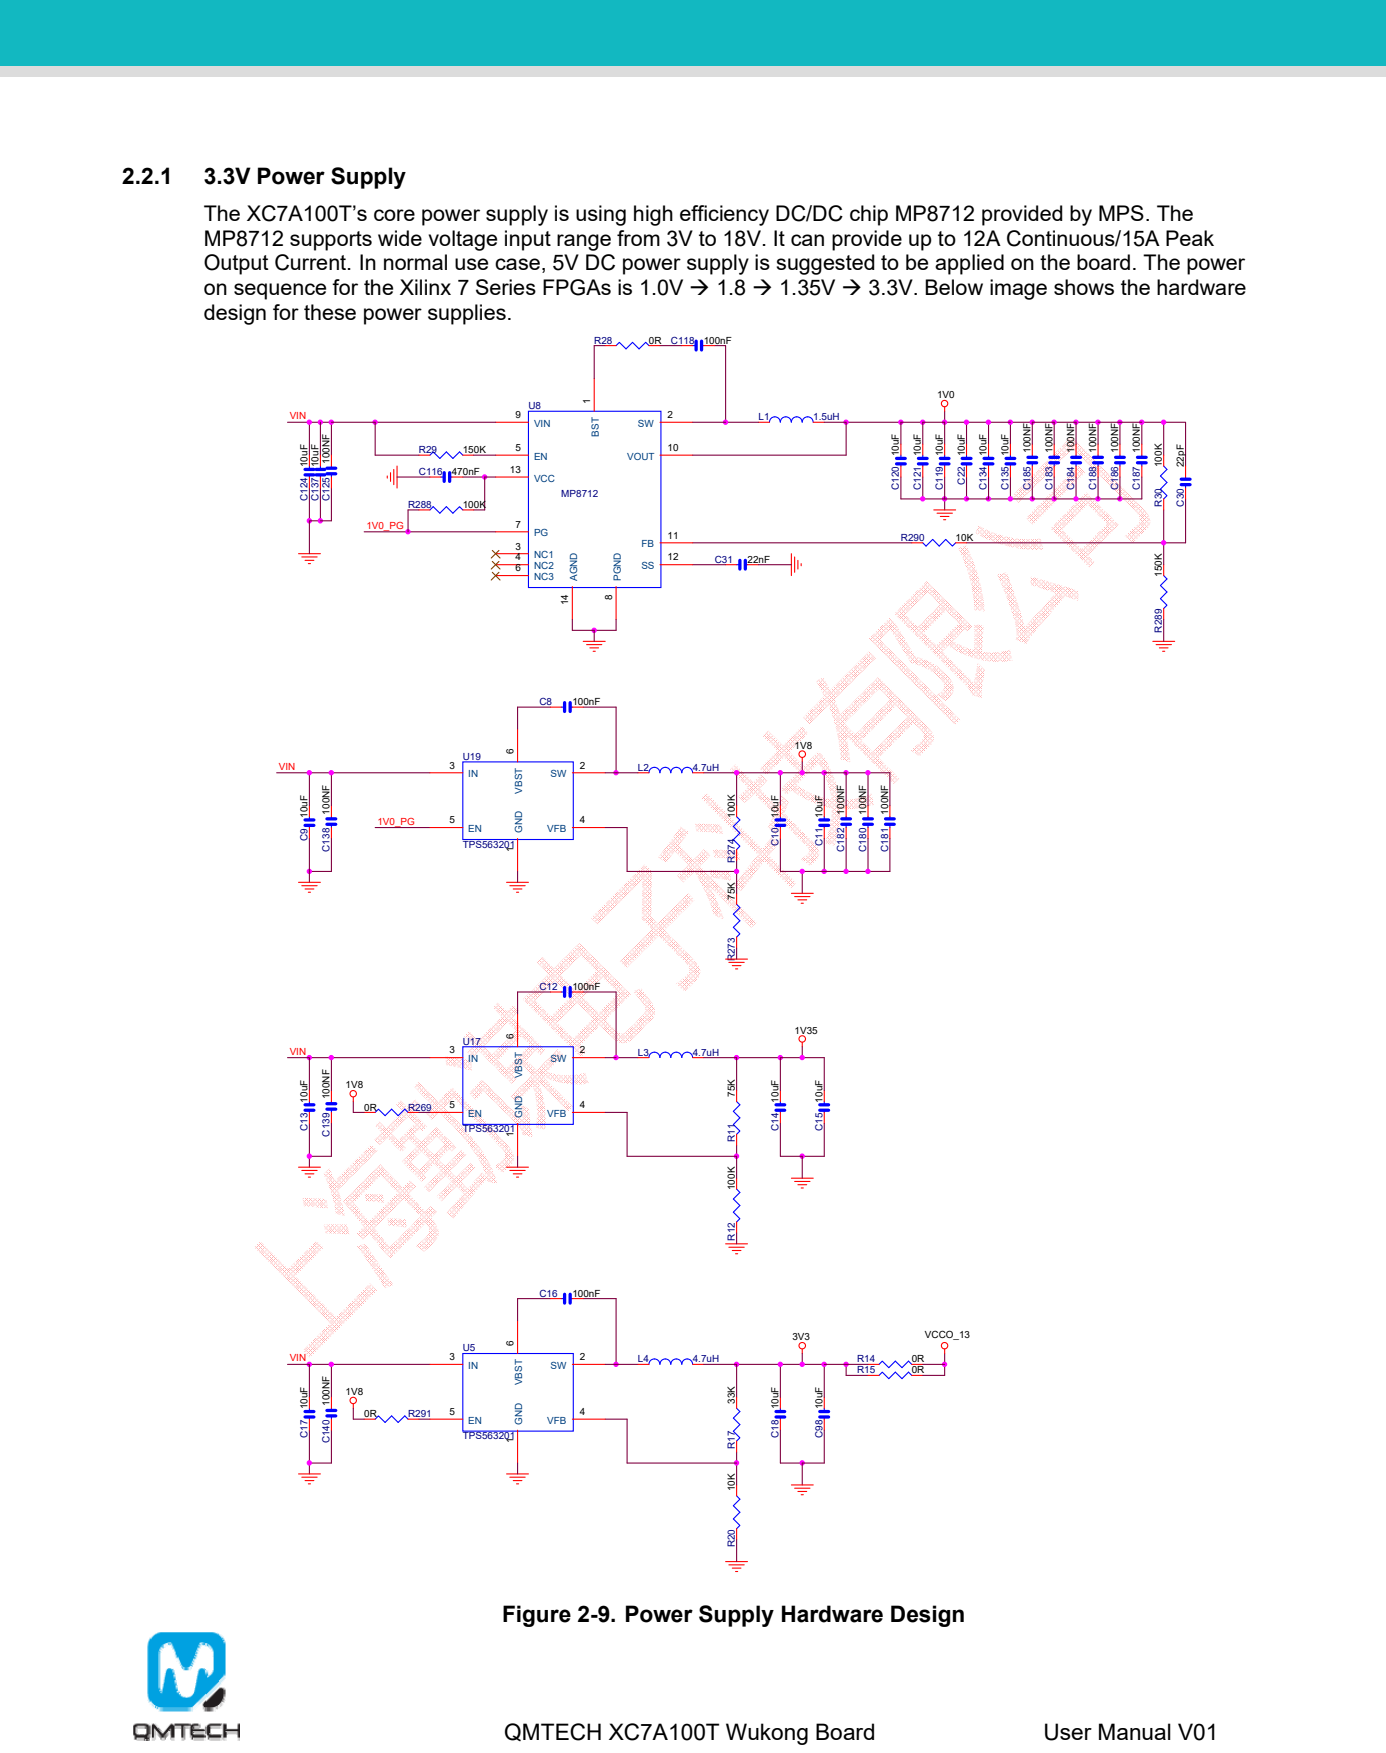
[picture p26: page 8]

The XC7A100T’s core power supply is using high efficiency DC/DC chip MP8712 provided by MPS. The
MP8712 supports wide voltage input range from 3V to 18V. It can provide up to 12A Continuous/15A Peak
Output Current. In normal use case, 5V DC power supply is suggested to be applied on the board. The power
on sequence for the Xilinx 7 Series FPGAs is 1.0V → 1.8 → 1.35V → 3.3V. Below image shows the hardware

Figure 2-9. Power Supply Hardware Design

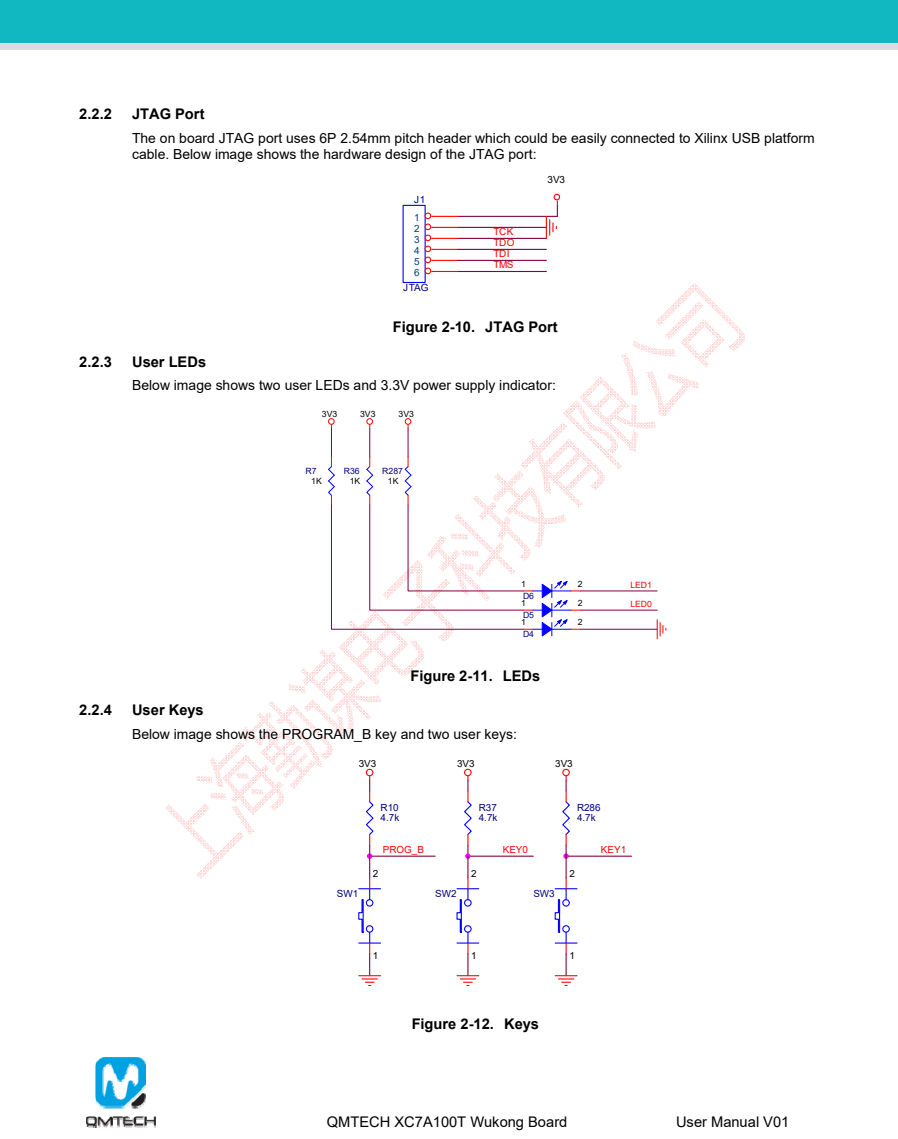
[picture p27: page 9]

The on board JTAG port uses 6P 2.54mm pitch header which could be easily connected to Xilinx USB platform
cable. Below image shows the hardware design of the JTAG port:

Below image shows two user LEDs and 3.3V power supply indicator:

Below image shows the PROGRAM_B key and two user keys:

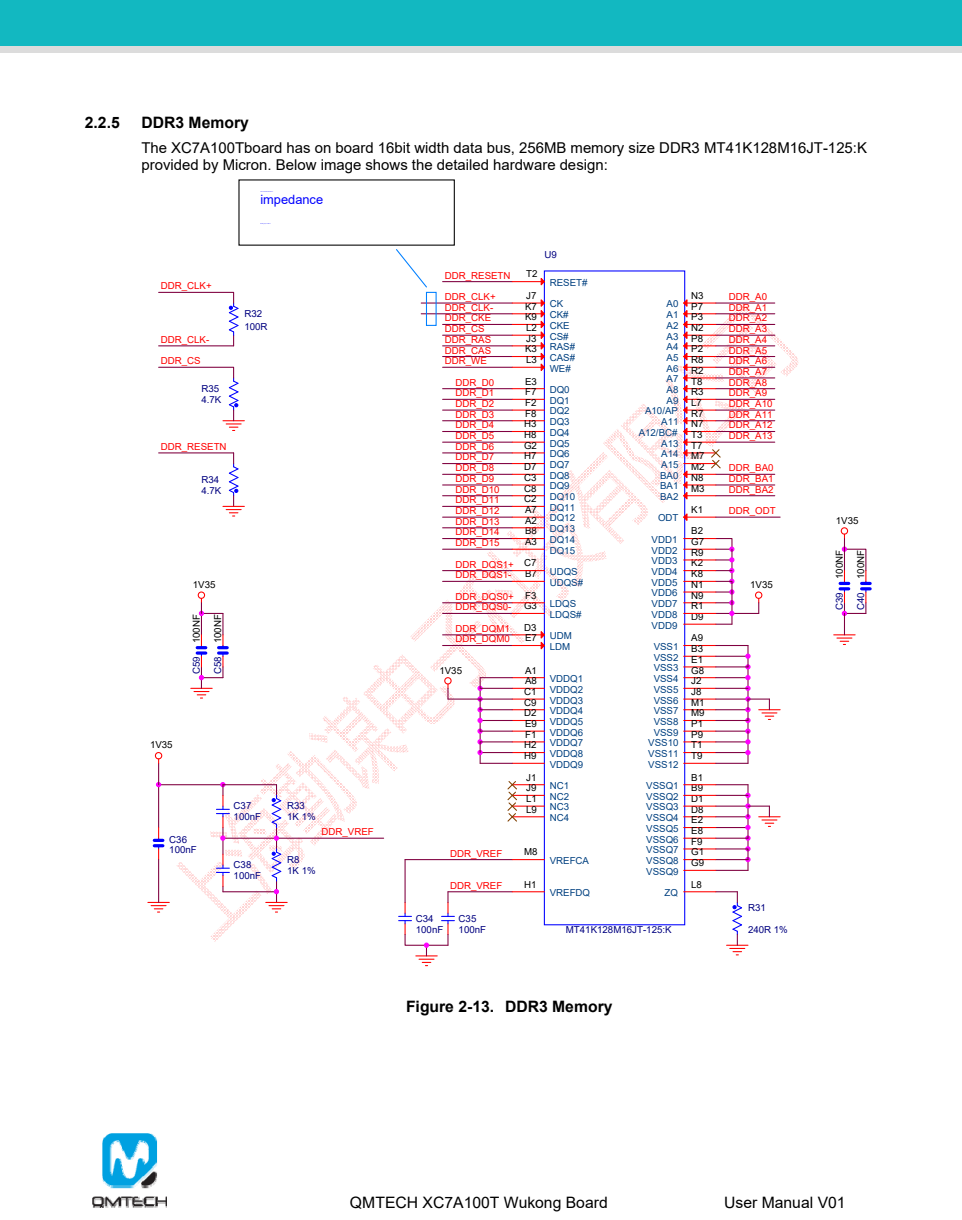
[picture p28: page 10]

The XC7A100Tboard has on board 16bit width data bus, 256MB memory size DDR3 MT41K128M16JT-125:K
provided by Micron. Below image shows the detailed hardware design:

Routing top or bottom

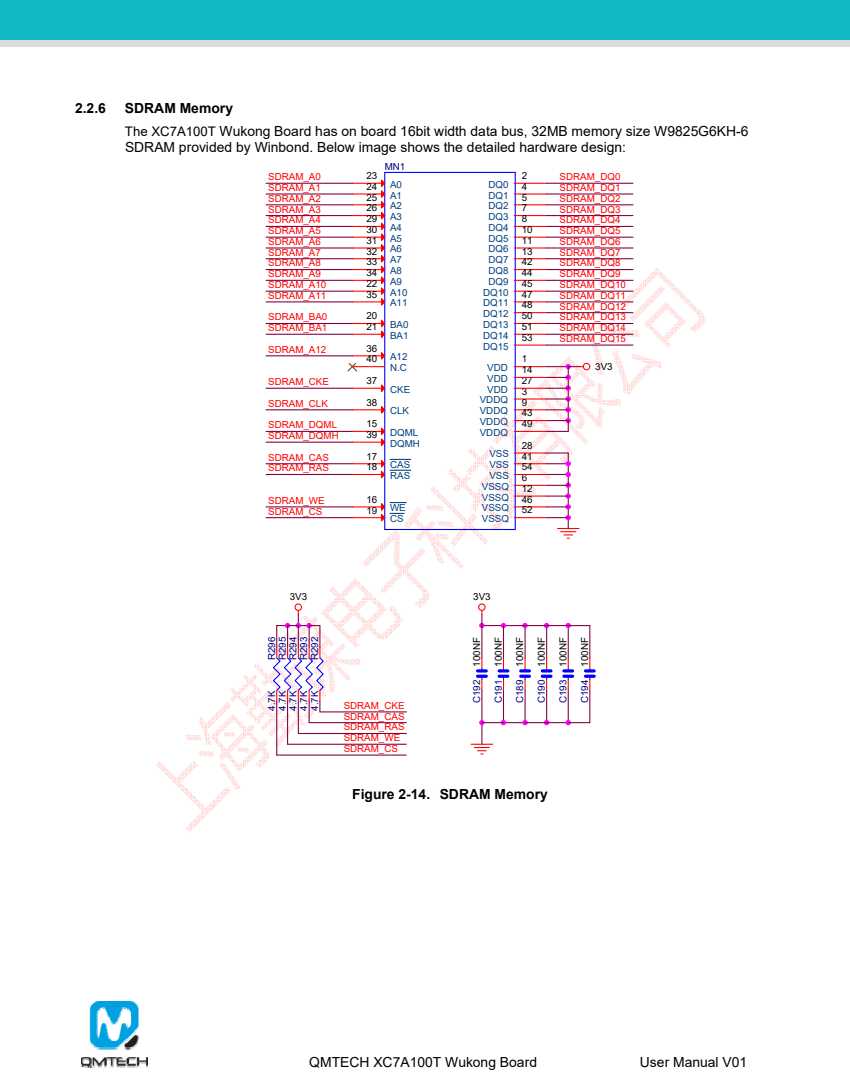
[picture p29: page 11]
2.2.6 SDRAM Memory; SDRAM provided by Winbond. Below image shows the detailed hardware design: C¹⁸⁹ ¹⁰⁰NF; C¹⁹⁰ ¹⁰⁰NF C¹⁹¹ ¹⁰⁰NF C¹⁹² ¹⁰⁰NF; VDD; VSS; VDDQ; CLK; CKE; DQML; DQMH; CAS; RAS; VSSQ; SDRAM, 256Mbit; SDRAM_DQML; SDRAM_BA1; SDRAM_CAS; SDRAM_CS; SDRAM_BA0; SDRAM_RAS; SDRAM_CKE; SDRAM_A12; SDRAM_DQMH; SDRAM_CLK; SDRAM_WER²⁹² 4.7K; SDRAM_WE; SDRAM_A11; SDRAM_A10; SDRAM_A9; SDRAM_A8; SDRAM_A4; SDRAM_A7; SDRAM_A6; SDRAM_A5; SDRAM_A1; SDRAM_A0; SDRAM_A3; SDRAM_A2; SDRAM_DQ8; SDRAM_DQ11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

The XC7A100T Wukong Board has on board 16bit width data bus, 32MB memory size W9825G6KH-6

Figure 2-14. SDRAM Memory

## 3. Reference

[1] ug470_7Series_Config.pdf
[2] ds181_Artix_7_Data_Sheet.pdf
[3] ug475_7Series_Pkg_Pinout.pdf
[4] N25Q64A.pdf
[5] MT41K128M16JT-125K.pdf

## 4. Revision

Doc. Rev. | Date | Comments
0.1 | 21/04/2021 | Initial Version.
1.0 | 26/04/2021 | V1.0 Formal Release.
1.0 | 27/01/2024 | V1.0 Formal Release for Wukong Board V3.
