ChinaQMTECH/QM_XC7A100T_WUKONG_BOARD/V2/User_Manual_XC7A200T/QMTECH_Artix-7_XC7A200T_Wukong_Board_V2_User_Manual(Hardware)_V01.pdf

QMTECH XC7A200T Wukong Board | User Manual V01

# QMTECH XC7A100T-200T WUKONG BOARD

# USER MANUAL

## Preface

The QMTech® XC7A200T Wukong board uses Xilinx Artix®-7 devices to demonstrate the highest performance-per-watt fabric, transceiver line rates, DSP processing, and AMS integration in a cost optimized FPGA. Featuring the MicroBlaze™ soft processor (https://www.xilinx.com/products/design-tools/microblaze.html) and 1,066Mb/s DDR3 support, the family is the best value for a variety of cost and power-sensitive applications including software-defined radio, machine vision cameras, and low-end wireless backhaul.

## Table of Contents

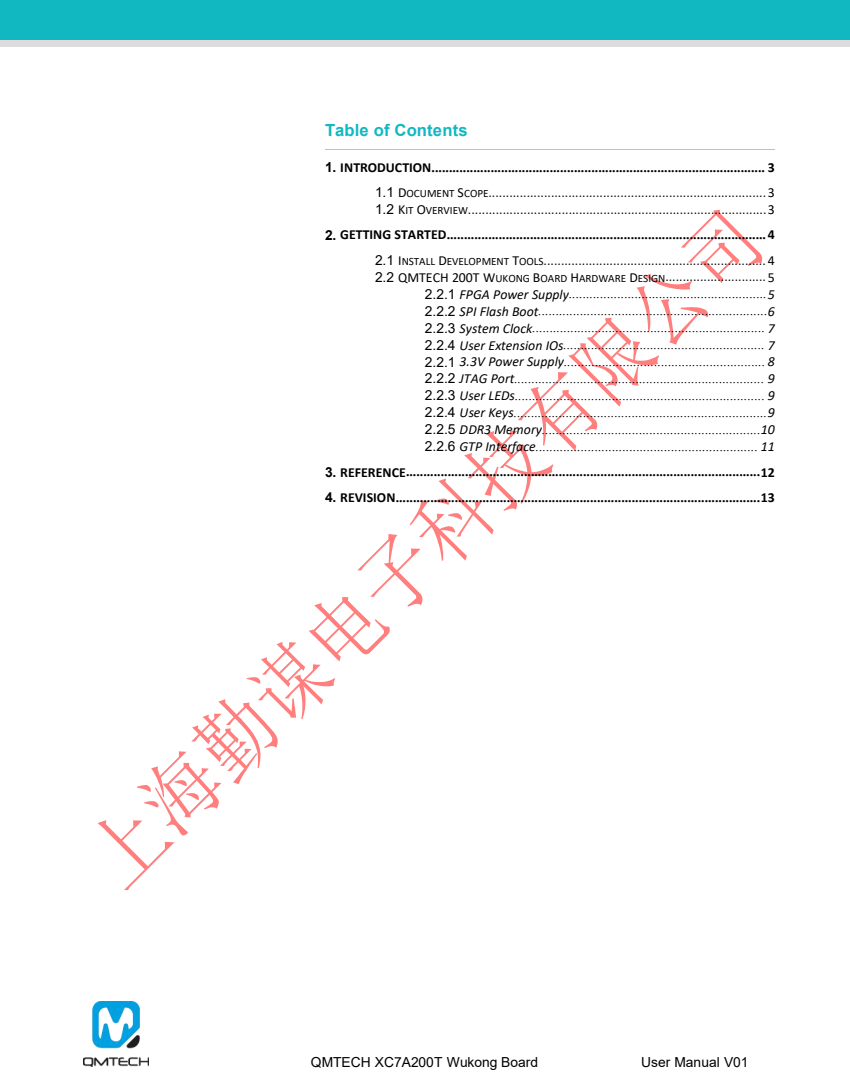
[picture p40: page 2]

## 1. Introduction

## 1.1 Document Scope

This demo user manual introduces the QMTECH XC7A200T Wukong board and describes how to setup the board running with application software Xilinx Vivado 2018.3. Users may employee the on board rich logic resource FPGA XC7A200T-1FBG676C and large DDR3 memory MT41K128M16 to implement various applications. The Wukong board also has many non-multiplexed FPGA IOs for extending customized modules, such as UART module, CMOS/CCD camera module, LCD/HDMI/VGA display

## module etc. 1.2 Kit Overview

Below section lists the parameters of the QMTECH XC7A200T Wukong board:
- On-Board FPGA: XC7A200T-1FBG676C;
- On-Board FPGA external crystal frequency: 50MHz;
- XC7A200T-1FBG676C has rich block RAM resource up to 13,140Kb;
- XC7A200T-1FBG676C has 215,360 logic cells;
- On-Board S25FL128L SPI Flash, 16M bytes for user configuration code;
- On-Board 256MB Micron DDR3, MT41K128M16JT-125:K;
- On-Board core power supply for FPGA by using MP8712 wide input range DC/DC;
- XC7A200T board provides camera interface, 2xPMOD headers and 40P Male header for User IOs;
- XC7A200T board has 3 user switches;
- XC7A200T board has 4 user LEDs;
- XC7A200T board has one Micro SD Card slot;
- XC7A200T board provides HDMI display interface;
- XC7A200T board provides GTP(4 lanes TX/RX) interface through 26P 2.54mm pitch header. XC7A200T board has JTAG interface, by using 6p, 2.54mm pitch header;
- XC7A200T board PCB size is: 9.96cm x 9.96cm;
- Default power source for board is: 2A@5V DC, the DC header type: DC-050, 5.5mmx2.1mm;

Figure 1-1. QMTECH XC7A200T Wukong Board Bottom View

## 2. Getting Started

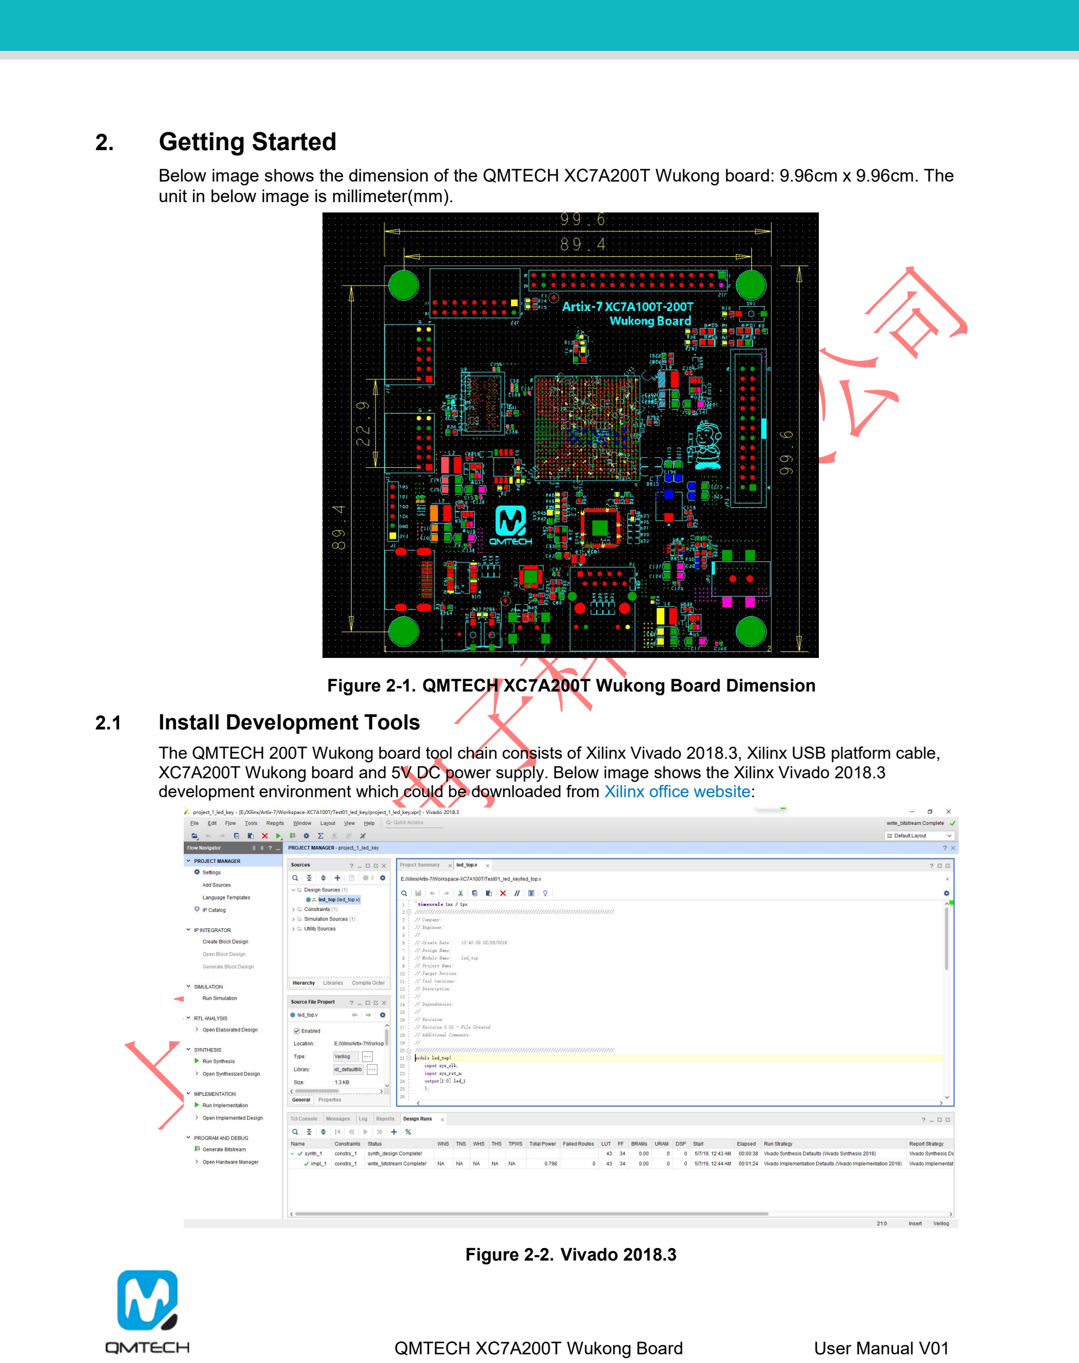
[picture p41: page 4]

Below image shows the dimension of the QMTECH XC7A200T Wukong board: 9.96cm x 9.96cm. The unit in below image is millimeter(mm).

Figure 2-1. QMTECH XC7A200T Wukong Board Dimension

## 2.1 Install Development Tools

The QMTECH 200T Wukong board tool chain consists of Xilinx Vivado 2018.3, Xilinx USB platform cable, XC7A200T Wukong board and 5V DC power supply. Below image shows the Xilinx Vivado 2018.3 development environment which could be downloaded from Xilinx office website: (https://www.xilinx.com/support/download/index.html/content/xilinx/en/downloadNav/design-tools.html)

Figure 2-2. Vivado 2018.3

## 2.2 QMTECH 200T Wukong Board Hardware Design

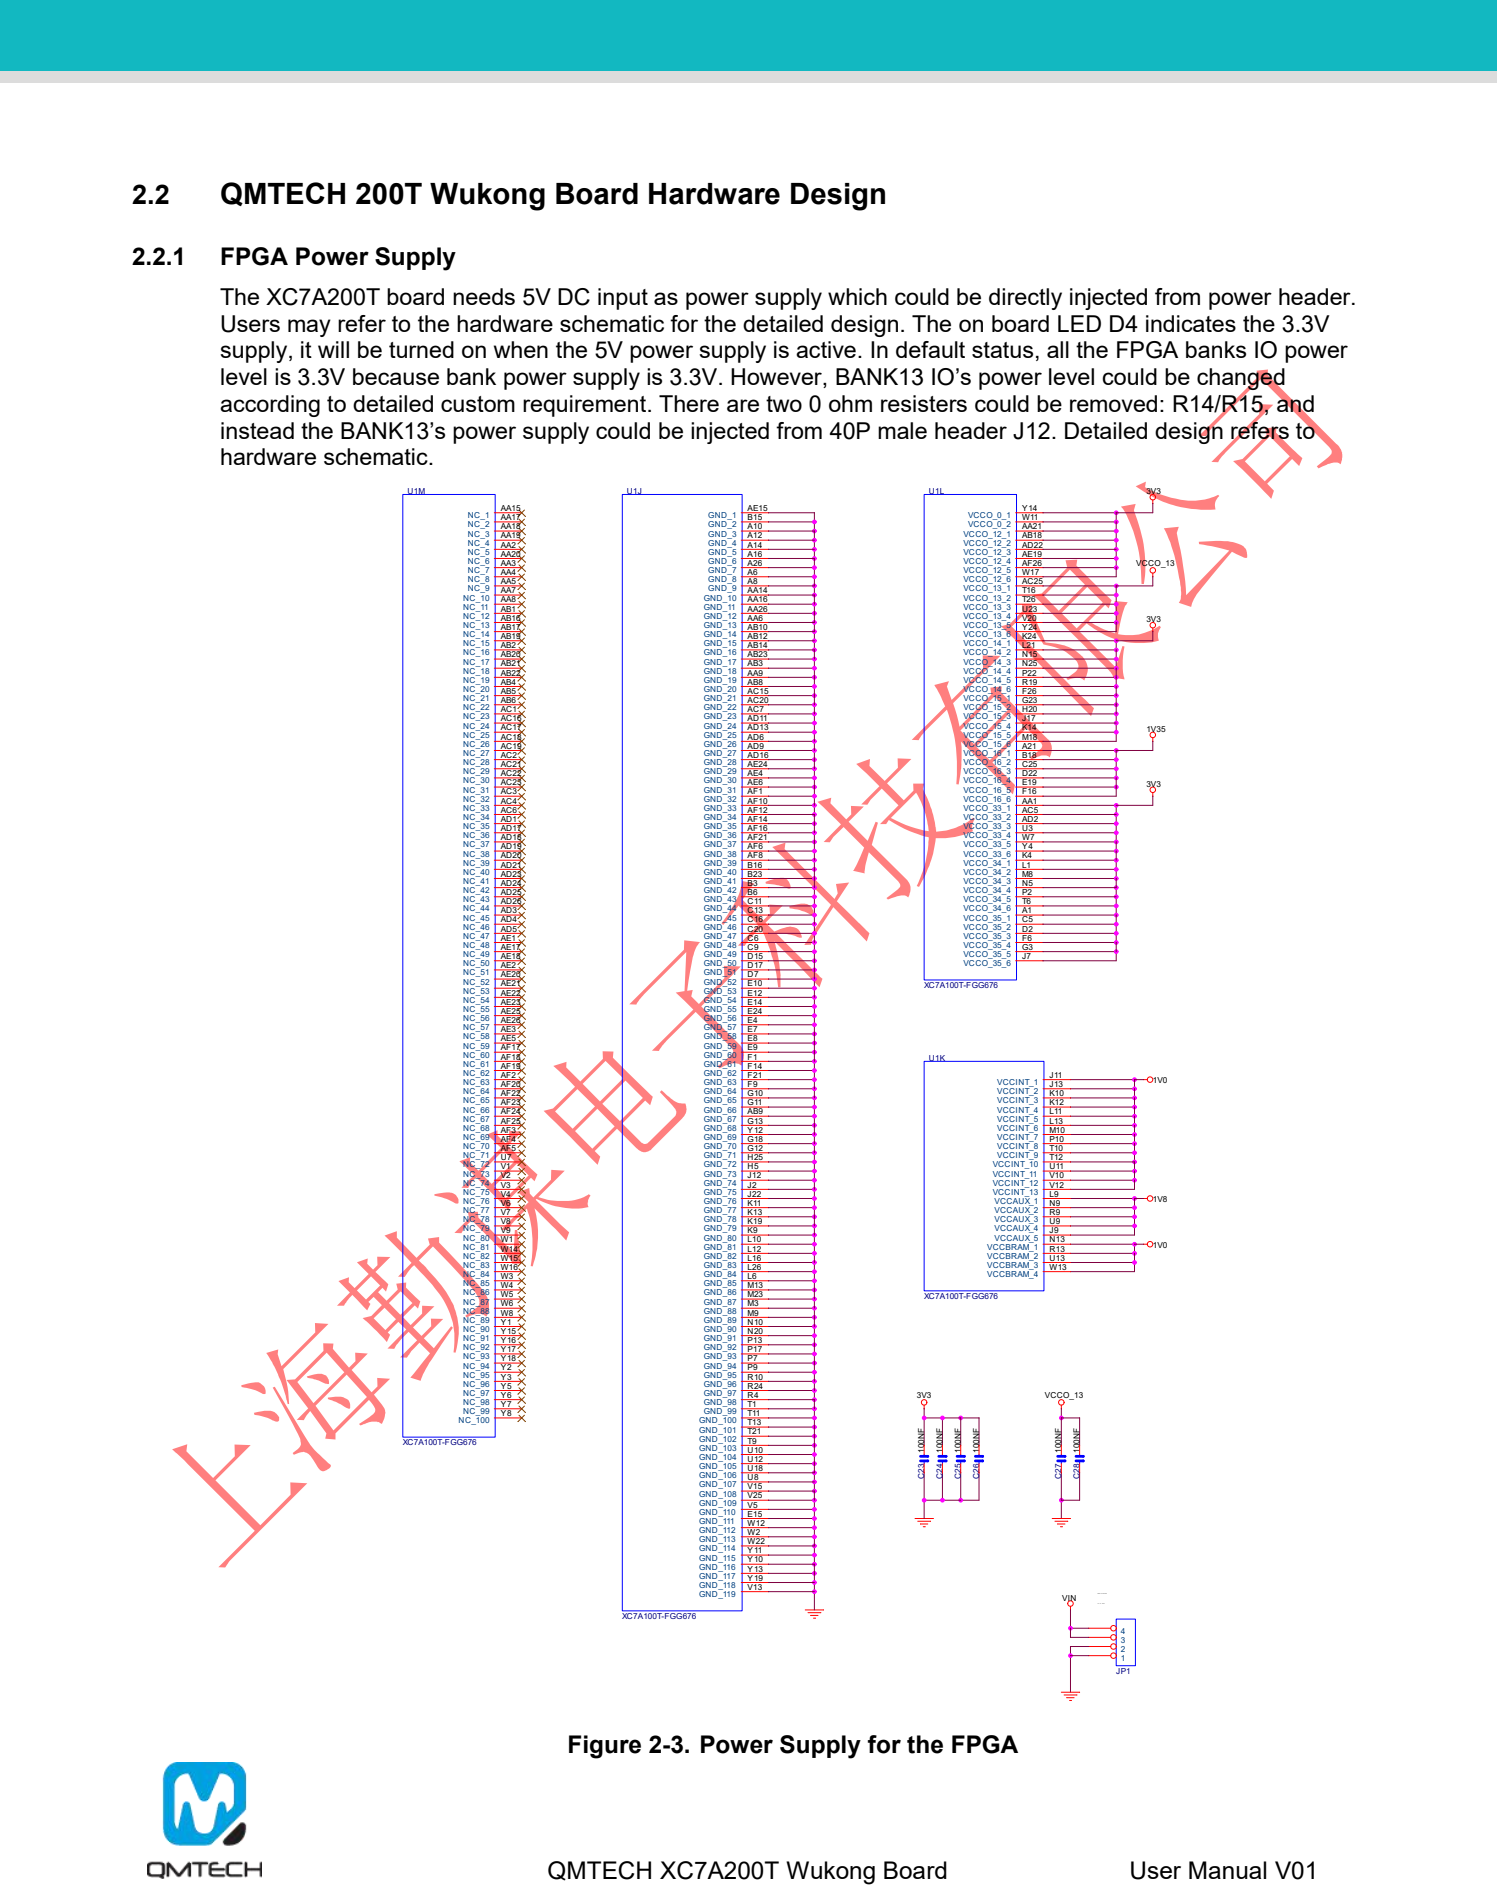
[picture p42: page 5]

2.2.1 FPGA Power Supply
The XC7A200T board needs 5V DC input as power supply which could be directly injected from power header. Users may refer to the hardware schematic for the detailed design. The on board LED D4 indicates the 3.3V
supply, it will be turned on when the 5V power supply is active. In default status, all the FPGA banks IO power
level is 3.3V because bank power supply is 3.3V. However, BANK13 IO’s power level could be changed
according to detailed custom requirement. There are two 0 ohm resisters could be removed: R14/R15, and
instead the BANK13’s power supply could be injected from 40P male header J12. Detailed design refers to
hardware schematic.

XC7A100T-FGG676
4 Figure 2-3. Power Supply for the FPGA

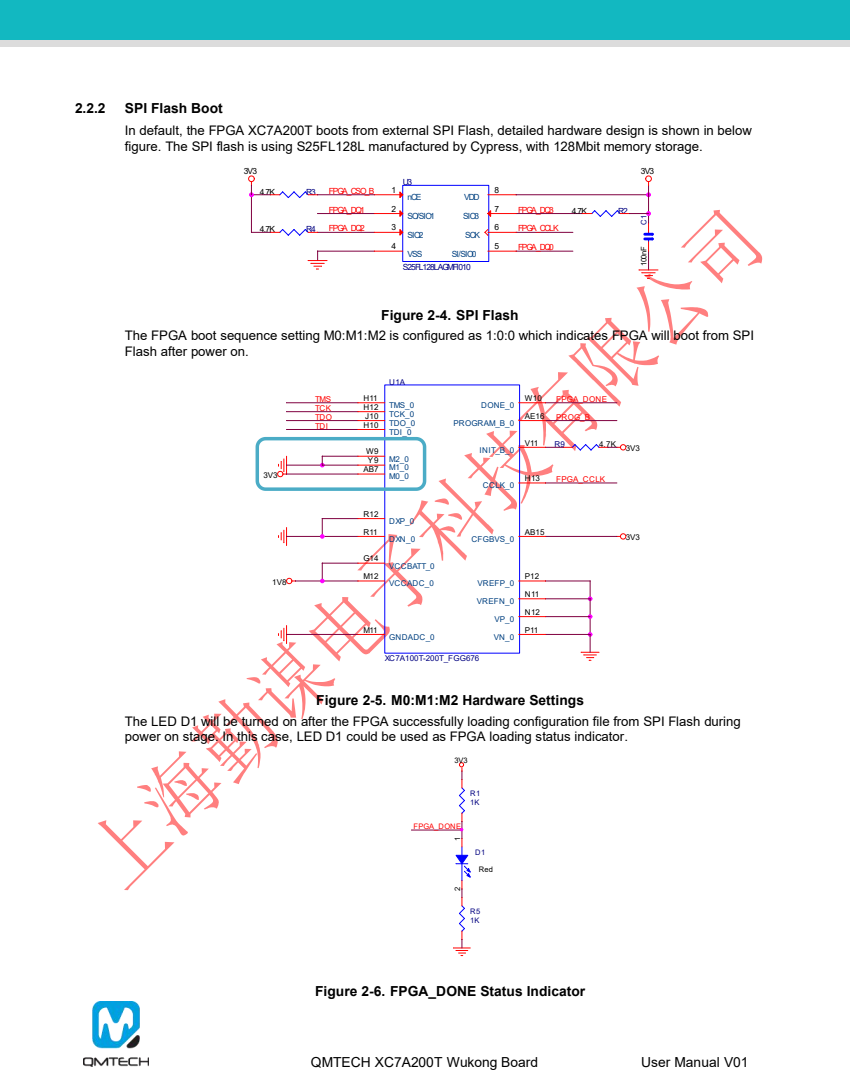
[picture p43: page 6]

2.2.2 SPI Flash Boot
In default, the FPGA XC7A200T boots from external SPI Flash, detailed hardware design is shown in below
figure. The SPI flash is using S25FL128L manufactured by Cypress, with 128Mbit memory storage.

The FPGA boot sequence setting M0:M1:M2 is configured as 1:0:0 which indicates FPGA will boot from SPI
Flash after power on.

The LED D1 will be turned on after the FPGA successfully loading configuration file from SPI Flash during
power on stage. In this case, LED D1 could be used as FPGA loading status indicator.

### 2.2.3 System Clock

FPGA chip XC7A200T-1FTG676C has system clock frequency 50MHz which is directly provided by external crystal. The crystal is designed with high accuracy and stability with low temperature drift 10ppm/°c. Below image shows the detailed hardware design:

C2
100NF
5 0 M H z

V D D

V S S | O U T

O E

Y1

SG-8002JC-50.0000M-PCB

1 | 4
2 | 3 SYS_CLK
R13 | 4.7K 3V3

Figure 2-7. 50MHz System Clock

### 2.2.4 User Extension IOs

The XC7A200T board has one 40P 2.54mm pitch male header which could be used for extending user modules, such as ADC/DAC module, audio/video module, ethernet module, etc.

VCCO_13 | VCCO_13
BANK13_AB26 | BANK13_AC26
BANK13_AB24 | BANK13_AC24
BANK13_AA24 | BANK13_AB25
BANK13_AA22 | BANK13_AA23
BANK13_Y25 | BANK13_AA25
BANK13_W25 | BANK13_Y26
BANK13_Y22 | BANK13_Y23
BANK13_W21 | BANK13_Y21
BANK13_V26 | BANK13_W26
BANK13_U25 | BANK13_U26
BANK13_V24 | BANK13_W24
BANK13_V23 | BANK13_W23
BANK13_V18 | BANK13_W18
| BANK13_V22
BANK13_U21

BANK13_U22
BANK13_V21
BANK13_T19
BANK13_T20 | BANK13_U20 BANK13_U19

VIN

J12

HDR_20X2

1 | 2
3 | 4
5 | 6
7 | 8
9 | 10
11 | 12
13 | 14
15 | 16
17 | 18
19 | 20
21 | 22
23 | 24
25 | 26
27 | 28
29 | 30
31 | 32
33 | 34
35 | 36
37 | 38
39 | 40

The XC7A200T board has 2 PMOD interfaces and one camera interface.

BANK35_D5 | BANK35_E5
BANK35_G5 | BANK35_E6
BANK35_G8

BANK35_G7
BANK35_G6

BANK35_D6

J10

PMOD

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
3V3 | 3V3
BANK35_A5 | BANK35_B5
BANK35_A4 | BANK35_B4
BANK35_H4 | BANK35_J4
BANK35_F4 | BANK35_G4

J11

PMOD

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
3V3 | 3V3

JP2

HDR_9X2

1 | 2
3 | 4
5 | 6
7 | 8
9 | 10
11 | 12
13 | 14
15 | 16
17 | 18
BANK15_H21 | BANK15_H22

3V3
BANK15_K21 | BANK15_J21
BANK15_G25
BANK15_H26 | BANK15_G26
BANK15_G20 | BANK15_G21 BANK15_F25
BANK15_E26 | BANK15_D26
BANK15_F23 | BANK15_E23
BANK15_E25 | BANK15_D25

Figure 2-8. Extension IO

External voltage supply
pins for BANK13. R14/R15 shall be removed before apply any voltage
to these two pins.

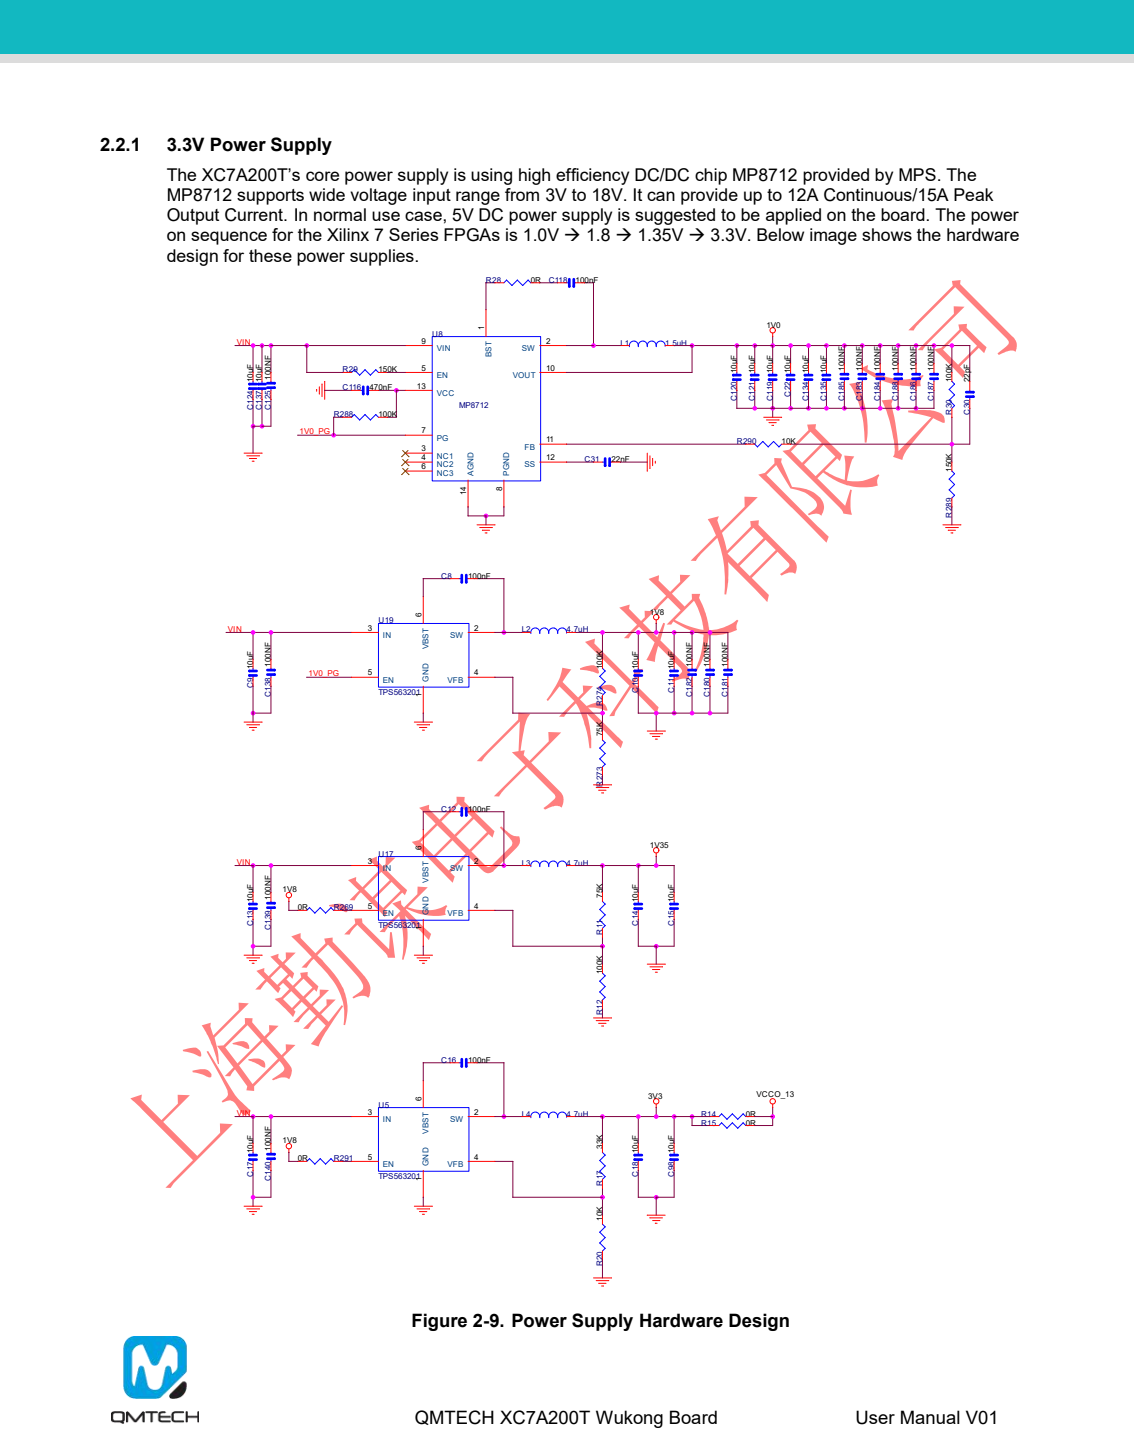
[picture p44: page 8]

2.2.1 3.3V Power Supply
The XC7A200T’s core power supply is using high efficiency DC/DC chip MP8712 provided by MPS. The
MP8712 supports wide voltage input range from 3V to 18V. It can provide up to 12A Continuous/15A Peak
Output Current. In normal use case, 5V DC power supply is suggested to be applied on the board. The power
on sequence for the Xilinx 7 Series FPGAs is 1.0V → 1.8 → 1.35V → 3.3V. Below image shows the hardware
design for these power supplies.

Figure 2-9. Power Supply Hardware Design

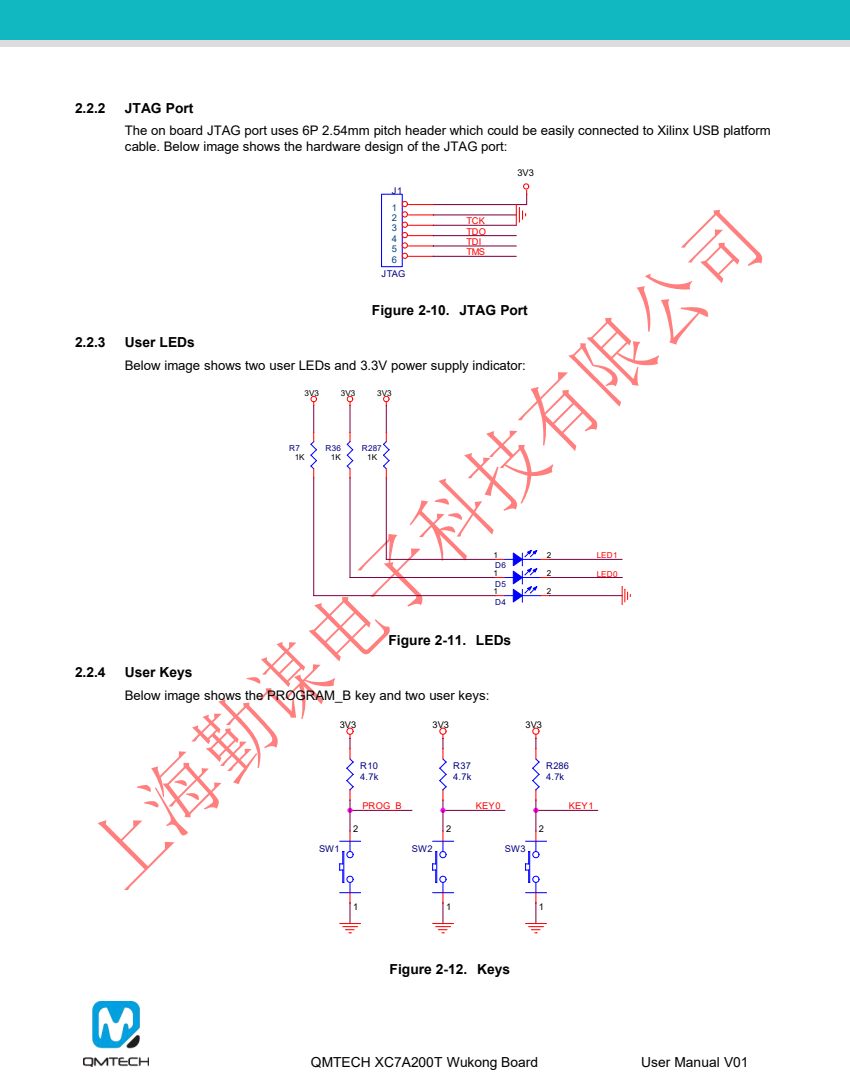
[picture p45: page 9]

2.2.2 JTAG Port
The on board JTAG port uses 6P 2.54mm pitch header which could be easily connected to Xilinx USB platform
cable. Below image shows the hardware design of the JTAG port:

2.2.3 User LEDs
Below image shows two user LEDs and 3.3V power supply indicator:

2.2.4 User Keys
Below image shows the PROGRAM_B key and two user keys:

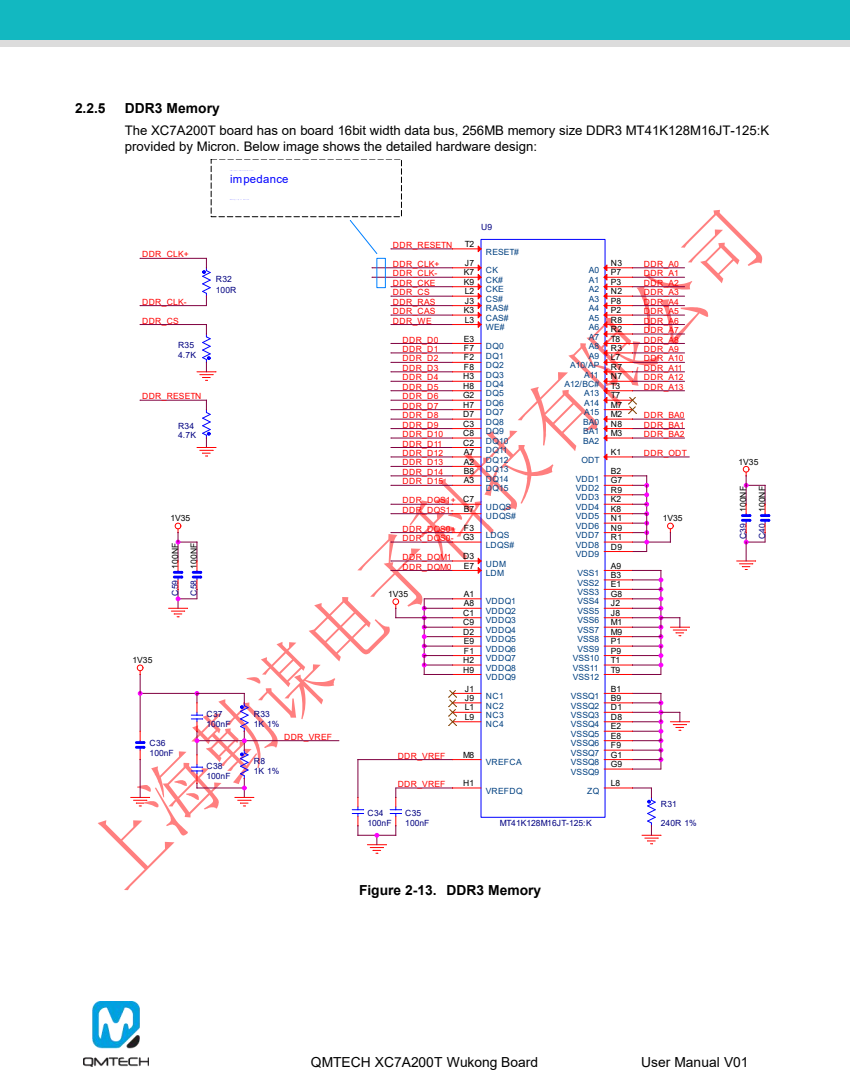
[picture p46: page 10]

2.2.5 DDR3 Memory
The XC7A200T board has on board 16bit width data bus, 256MB memory size DDR3 MT41K128M16JT-125:K
provided by Micron. Below image shows the detailed hardware design:

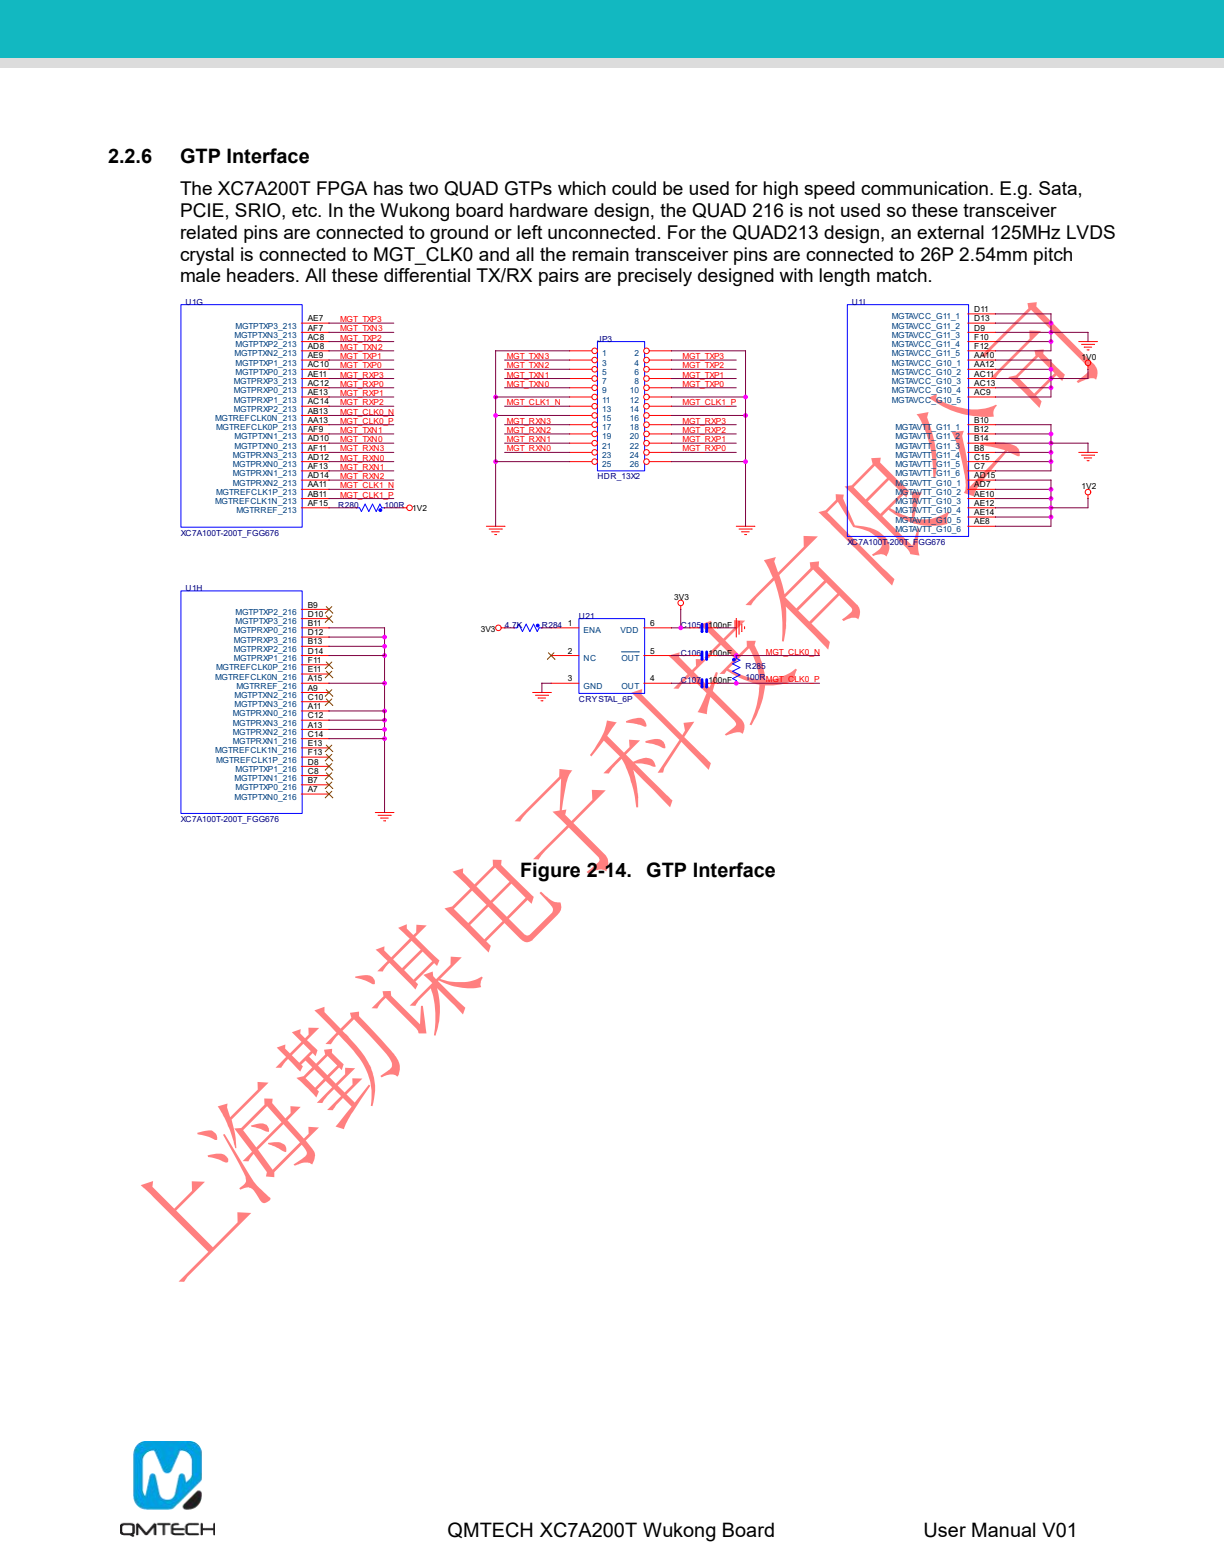
[picture p47: page 11]

2.2.6 GTP Interface
The XC7A200T FPGA has two QUAD GTPs which could be used for high speed communication. E.g. Sata, PCIE, SRIO, etc. In the Wukong board hardware design, the QUAD 216 is not used so these transceiver
related pins are connected to ground or left unconnected. For the QUAD213 design, an external 125MHz LVDS
crystal is connected to MGT_CLK0 and all the remain transceiver pins are connected to 26P 2.54mm pitch
male headers. All these differential TX/RX pairs are precisely designed with length match.

## 3. Reference

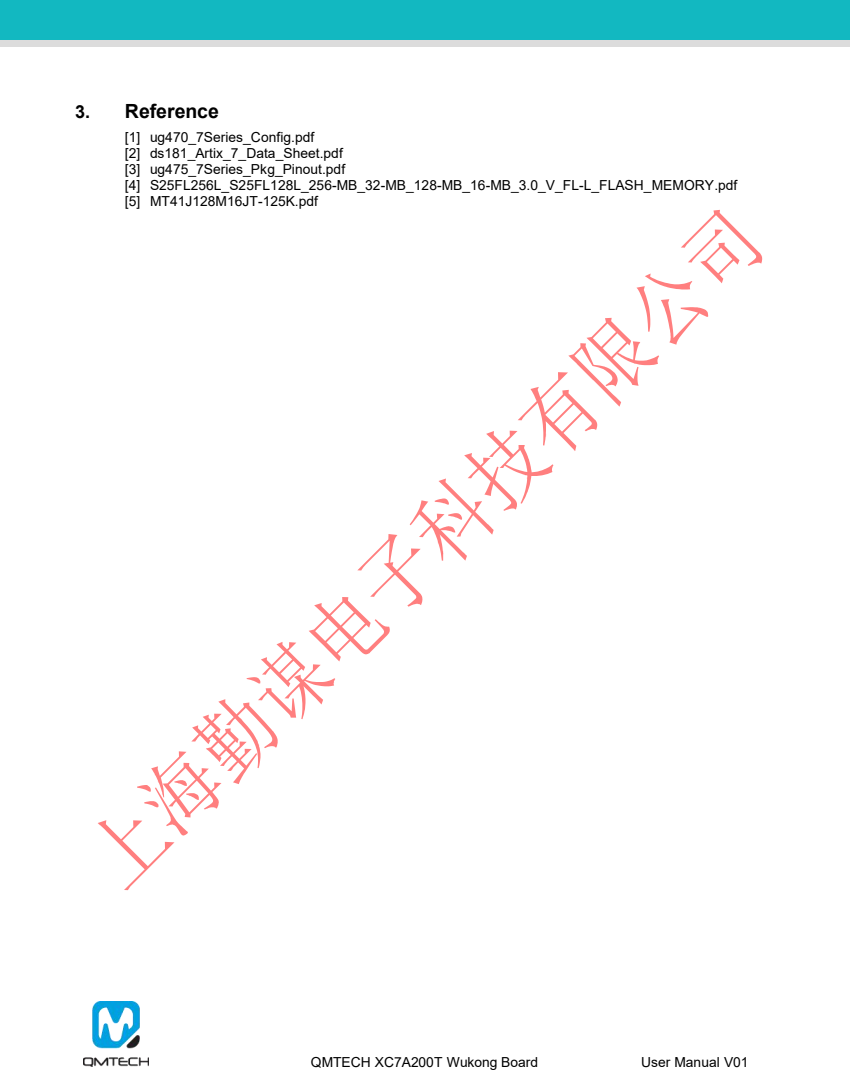
[picture p48: page 12]
[1] ug470_7Series_Config.pdf [2] ds181_Artix_7_Data_Sheet.pdf [3] ug475_7Series_Pkg_Pinout.pdf [4] S25FL256L_S25FL128L_256-MB_32-MB_128-MB_16-MB_3.0_V_FL-L_FLASH_MEMORY.pdf [5] MT41J128M16JT-125K.pdf

## 4. Revision

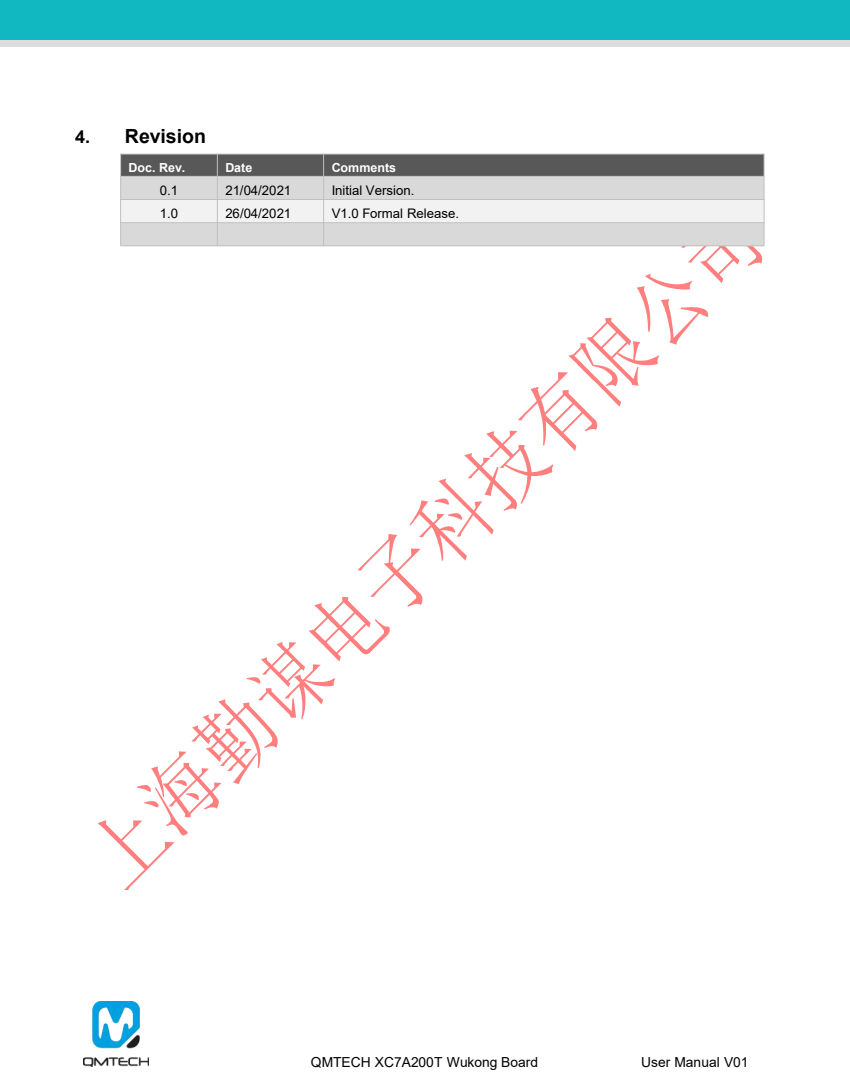
[picture p49: page 13]

Doc. Rev. | Date | Comments
0.1 | 21/04/2021 26/04/2021 | Initial Version. 1.0 V1.0 Formal Release.
