ChinaQMTECH/QM_XC7A100T_WUKONG_BOARD/V3/Hardware/QMTECH-XC7A100T_200T-Wukong-Board-V03-20240121.pdf

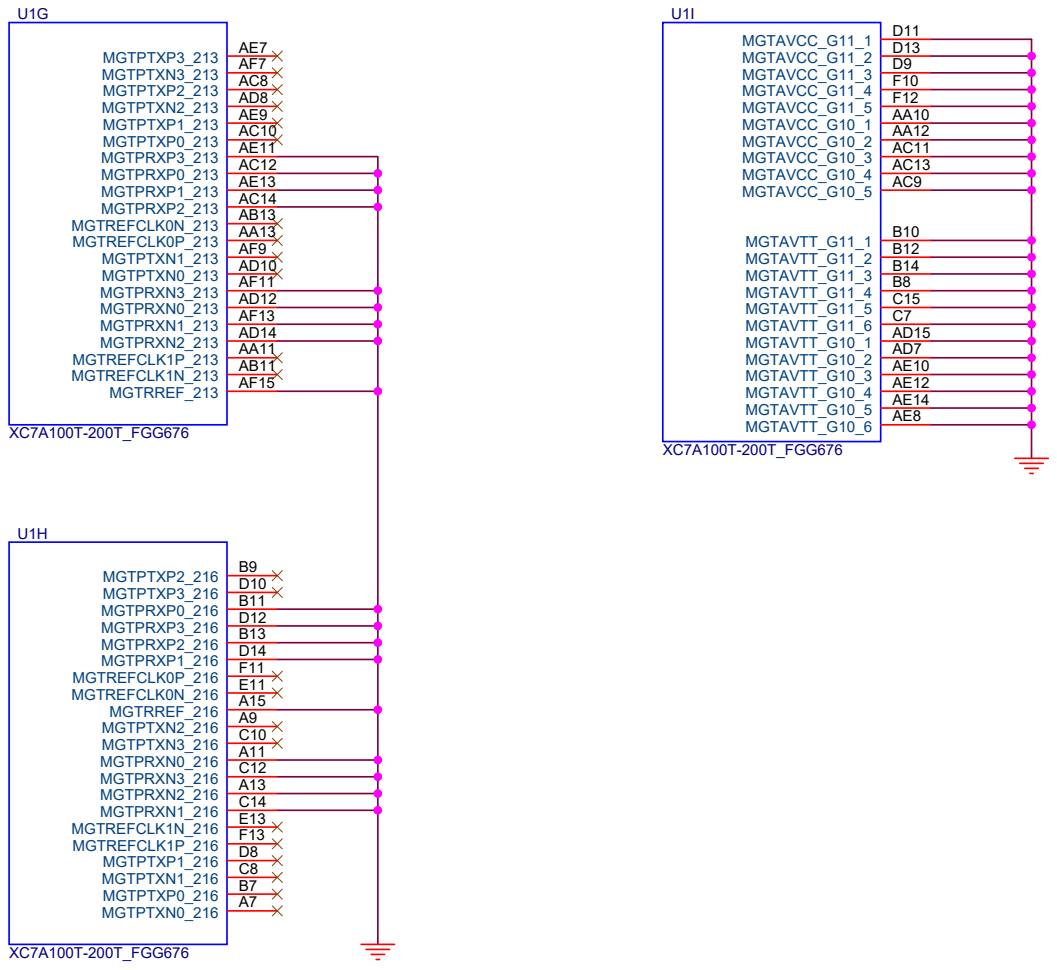
[picture p56: page 7]
