ChinaQMTECH/QM_XC7A100T_WUKONG_BOARD/V3/Hardware/QMTECH-XC7A100T_200T-Wukong-Board-V03-20240121.pdf

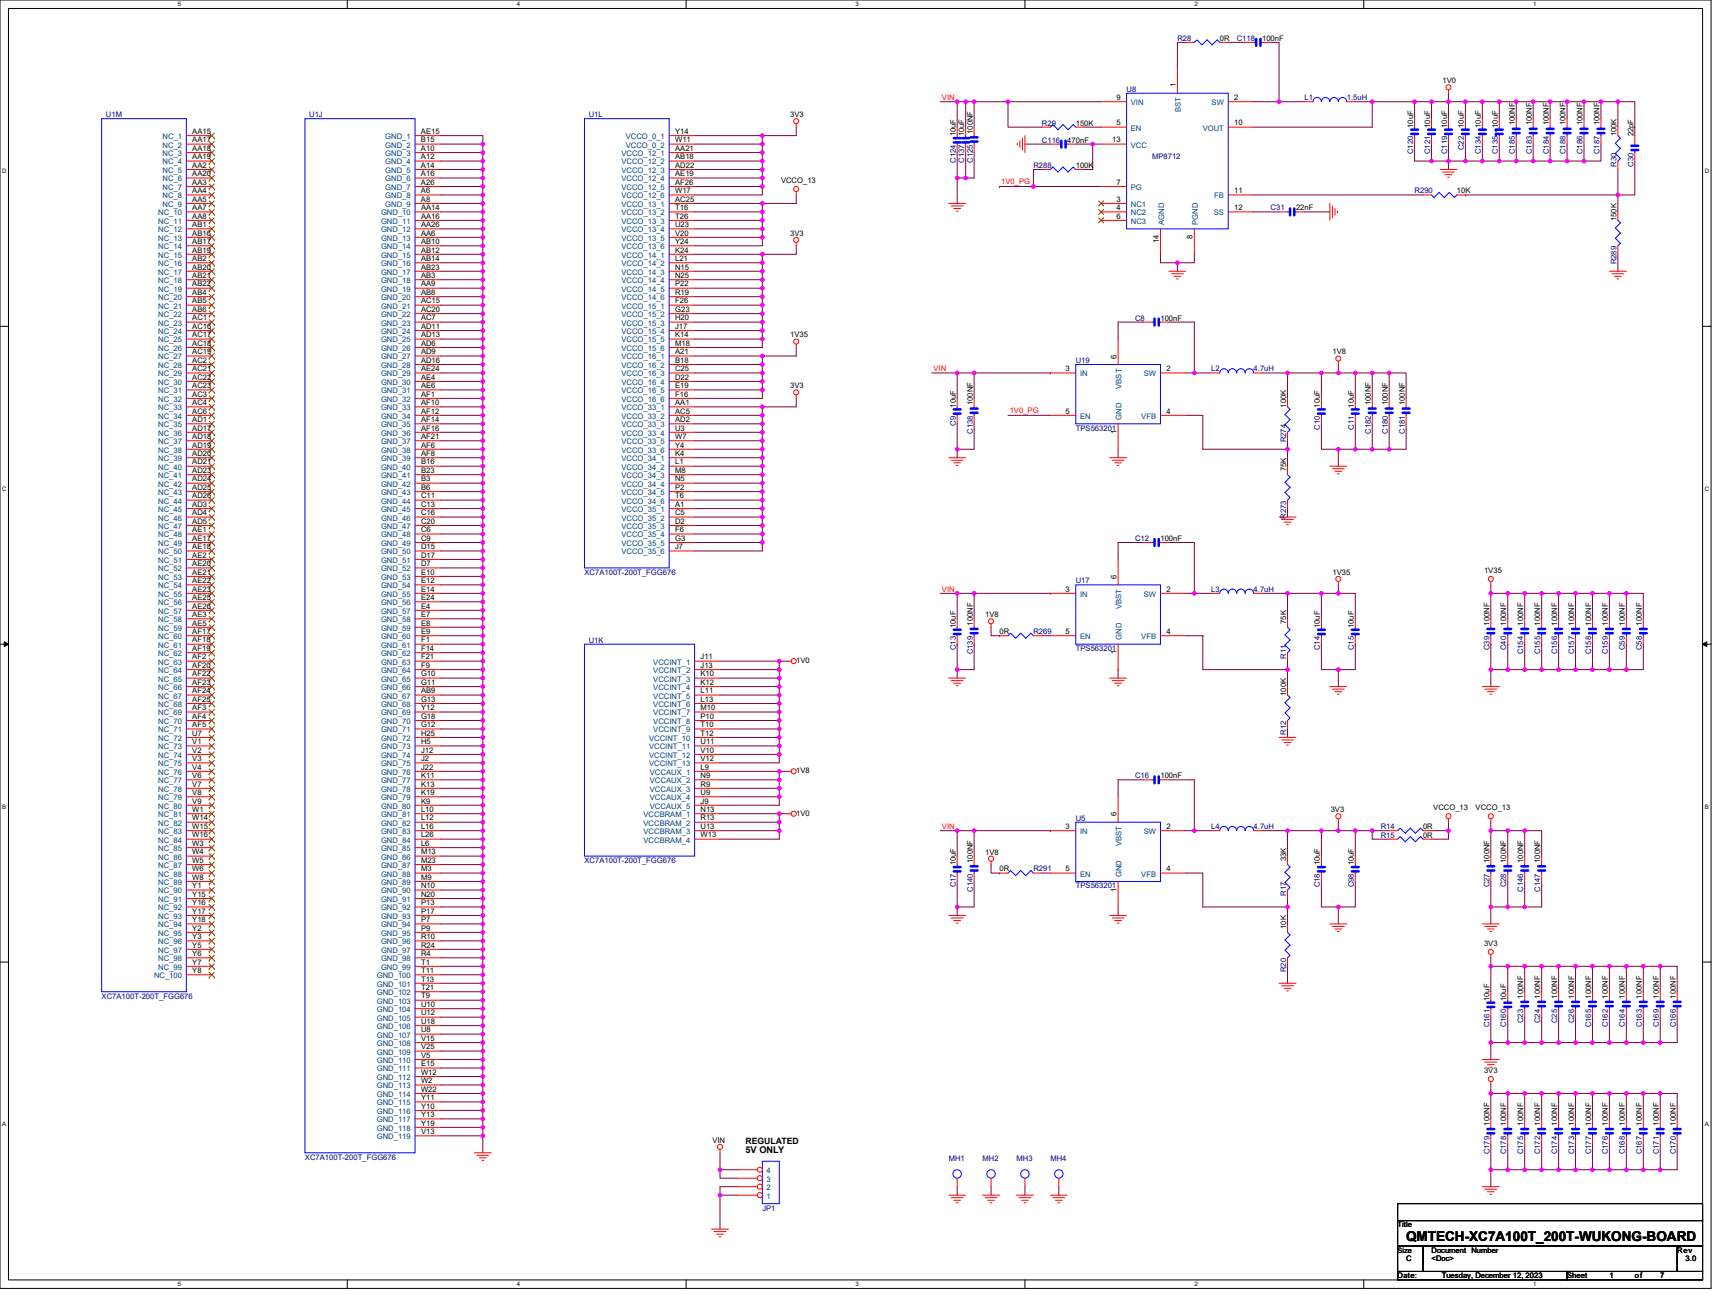
[picture p50: page 1]

Size C C C | Document Number <Doc> | Rev 3.0

Date: Tuesday, December 12, 2023 Tuesday, December 12, 2023 Tuesday, December 12, 2023 | Sheet 1 1 1 of 7 7 7

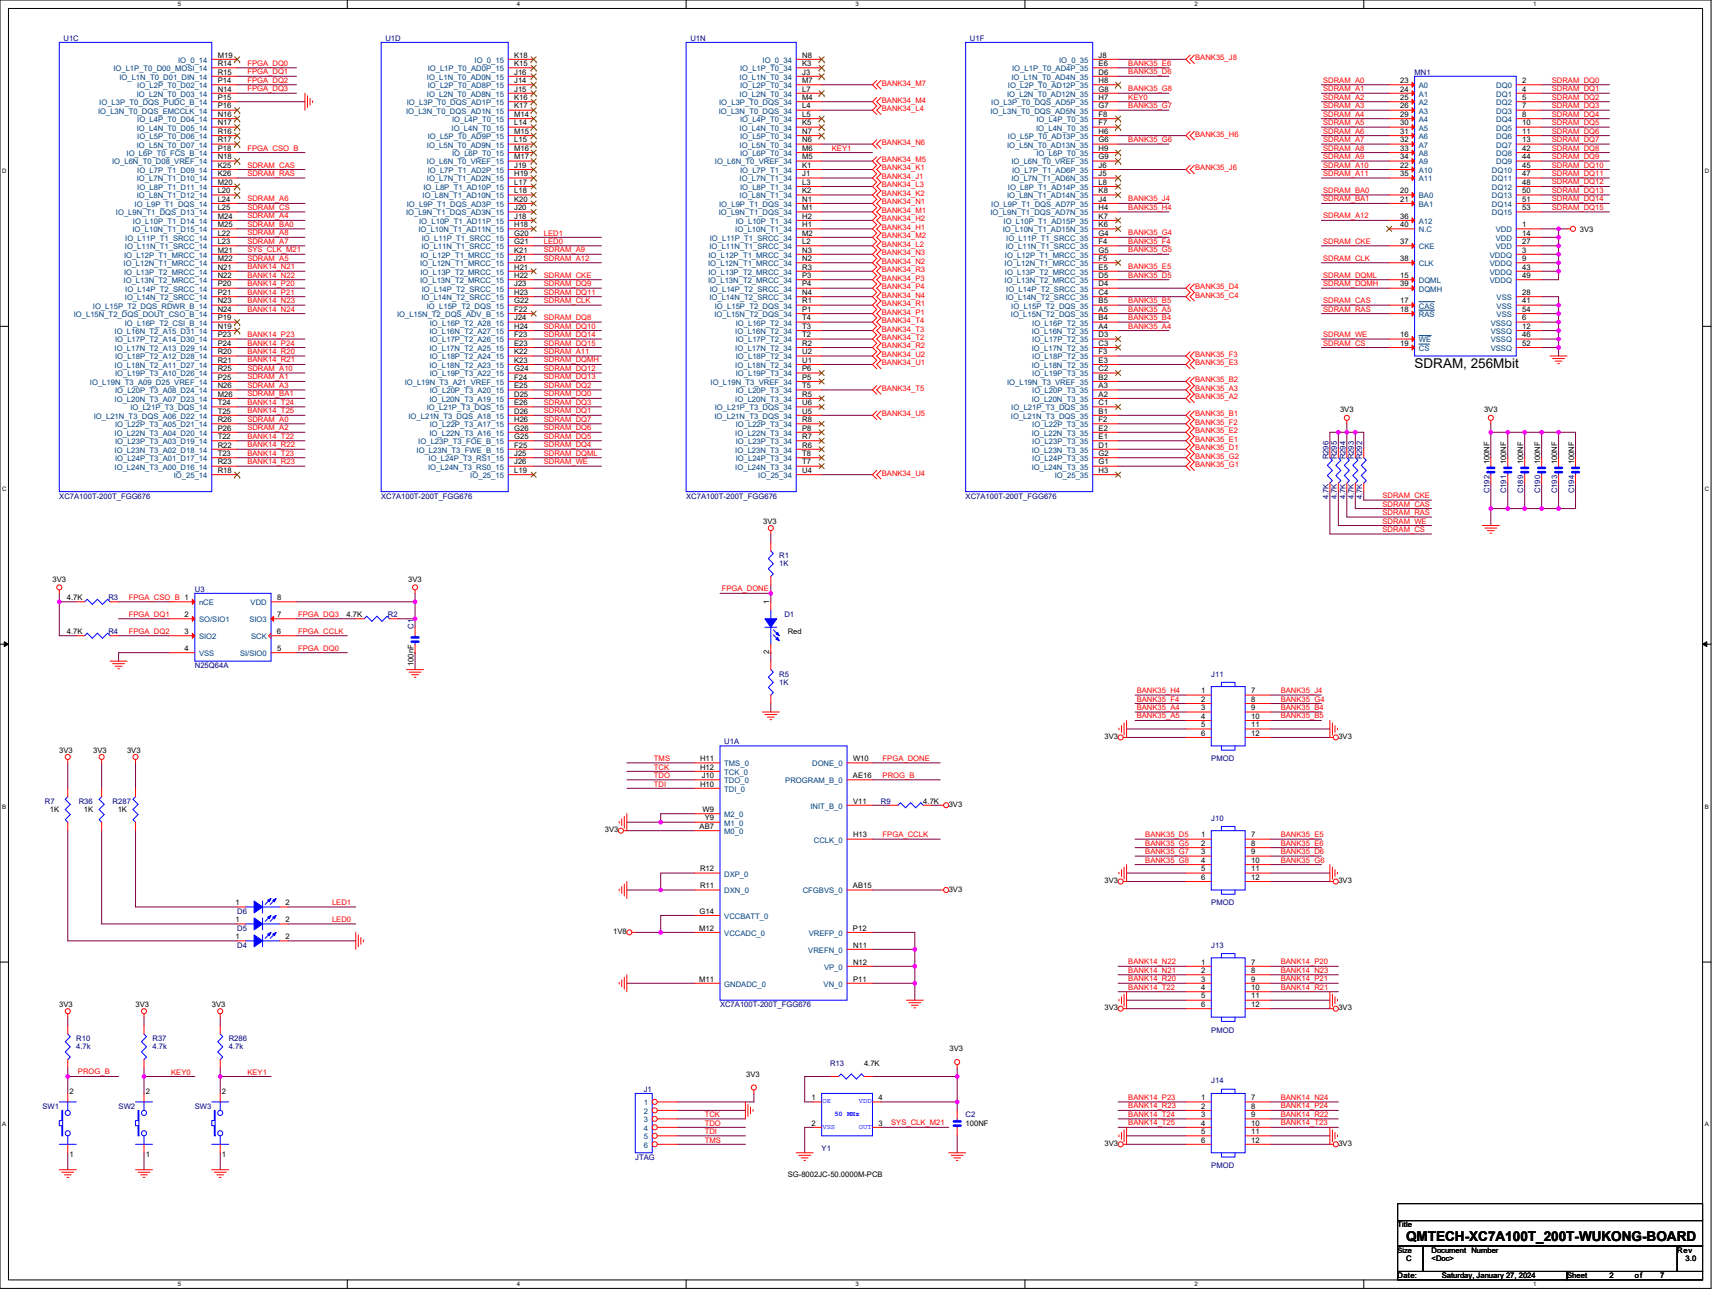
[picture p51: page 2]

5 | 11
6 | 12

Saturday, January 27, 2024 Saturday, January 27, 2024 Saturday, January 27, 2024 | 2 2 2 7 7 7

D

D

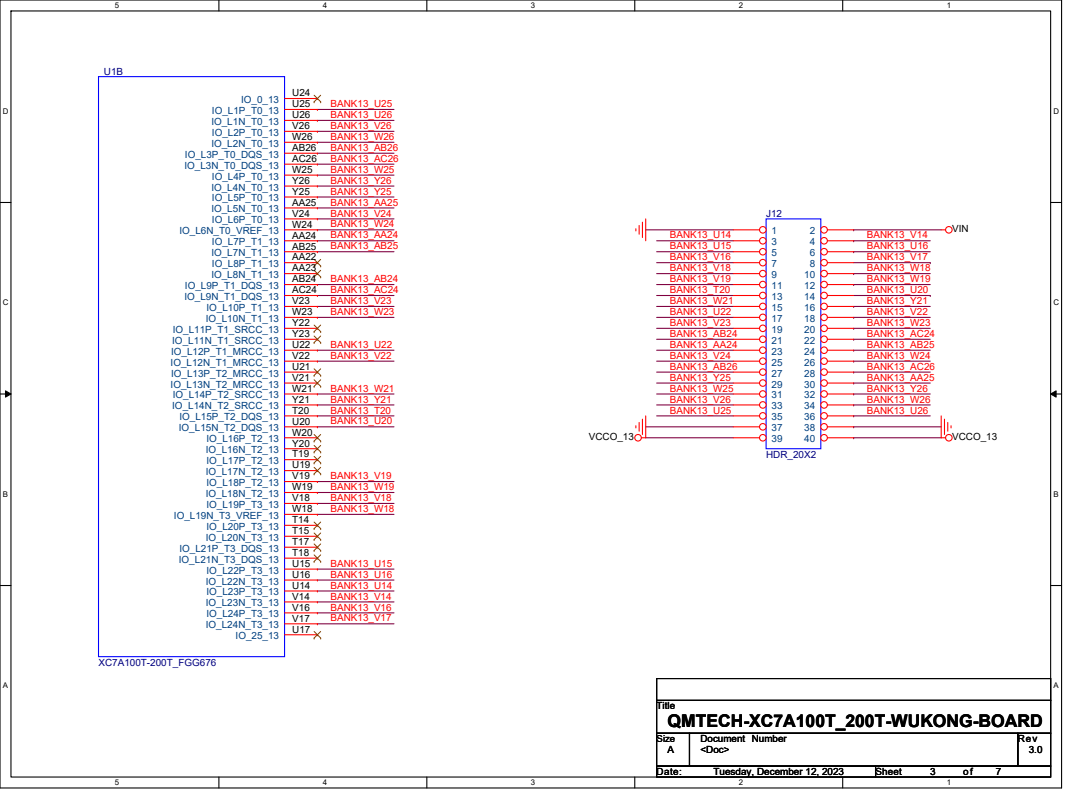
[picture p52: page 3]

Tuesday, December 12, 2023 Tuesday, December 12, 2023 Tuesday, December 12, 2023 | 3 3 3 7 7 7

D | D

# 100 ohms differential trace

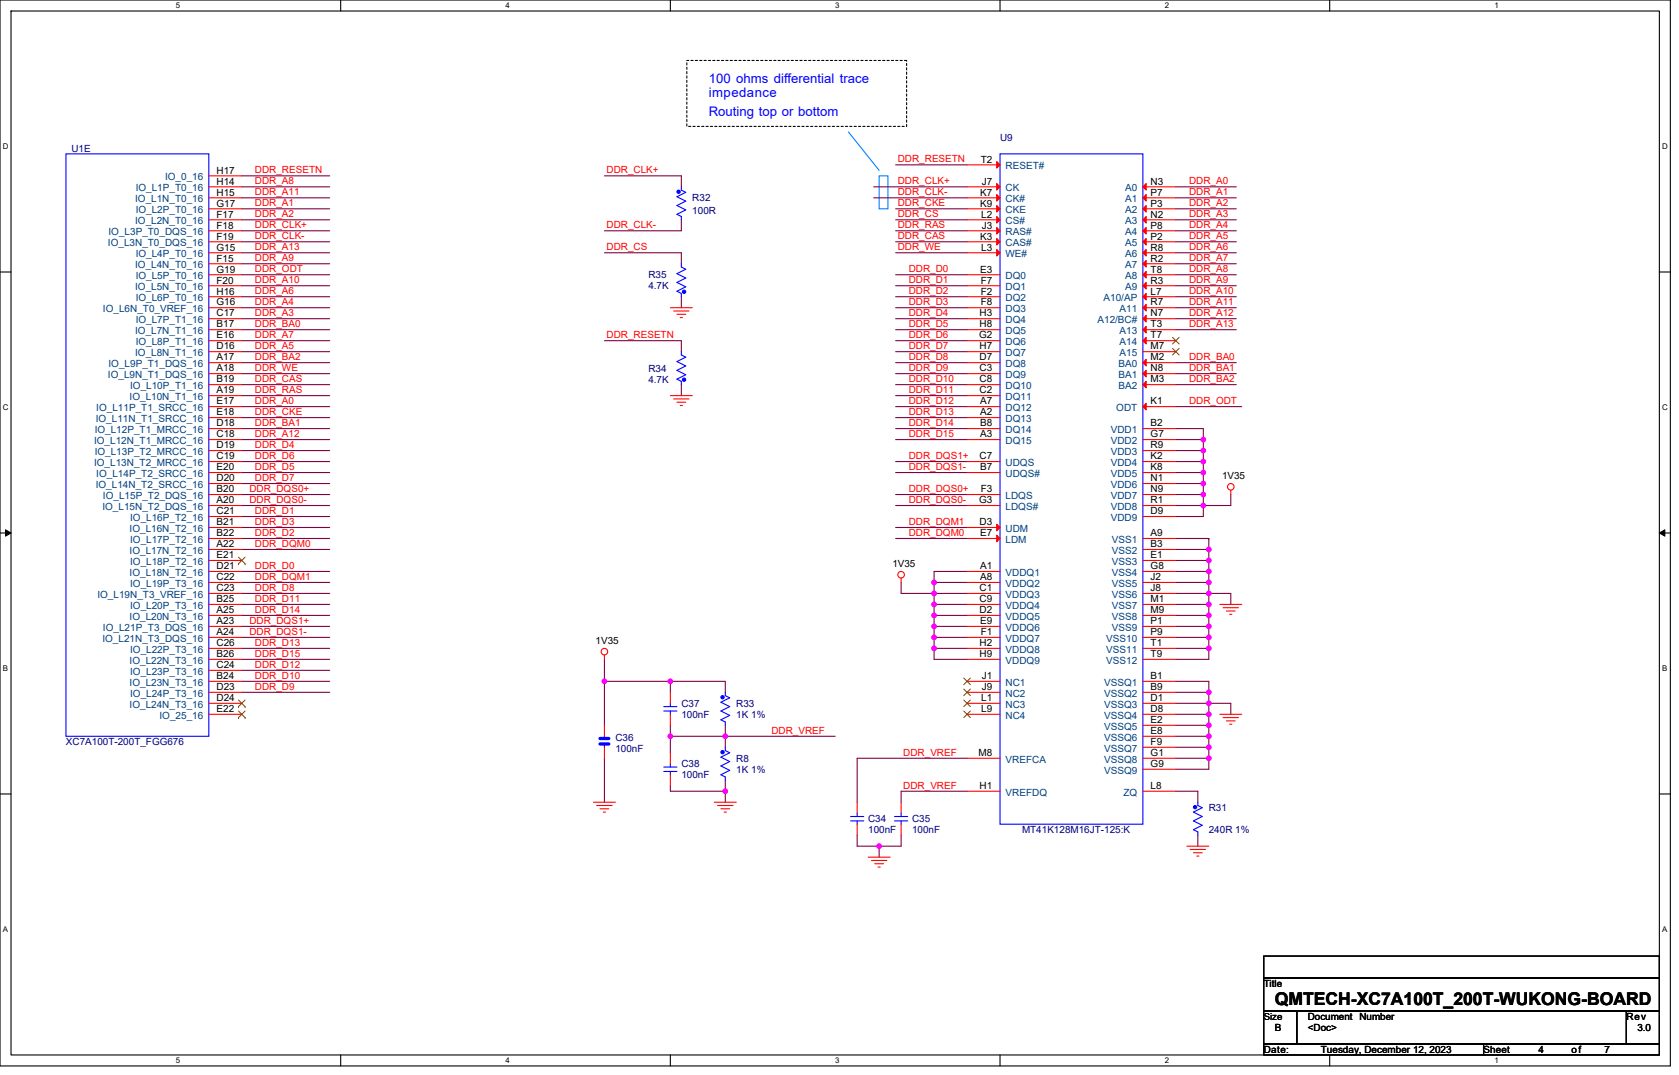
[picture p53: page 4]

impedance
Routing top or bottom

Tuesday, December 12, 2023 Tuesday, December 12, 2023 Tuesday, December 12, 2023 | 4 4 4 7 7 7

D | D

# PHY Address[2:0] = 001b

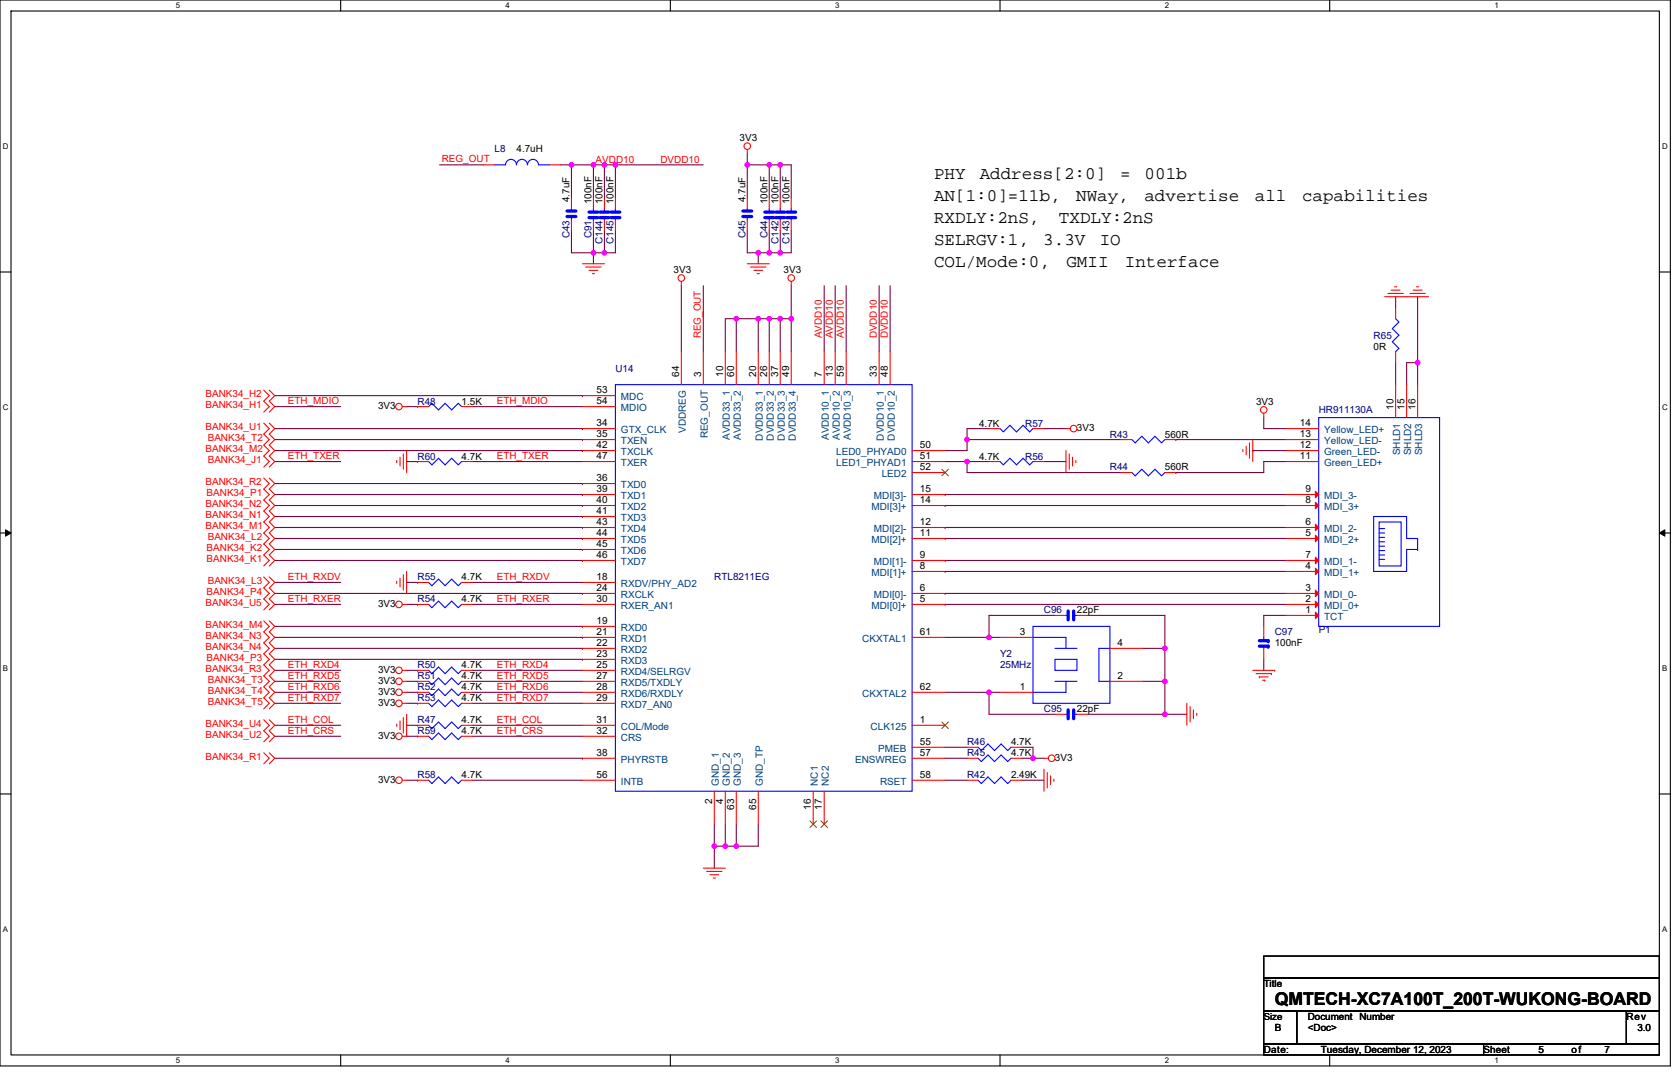
[picture p54: page 5]

AN[1:0]=11b, NWay, advertise all capabilities
RXDLY:2nS, TXDLY:2nS
SELRGV:1, 3.3V IO
COL/Mode:0, GMII Interface

D | D

## CEC_B

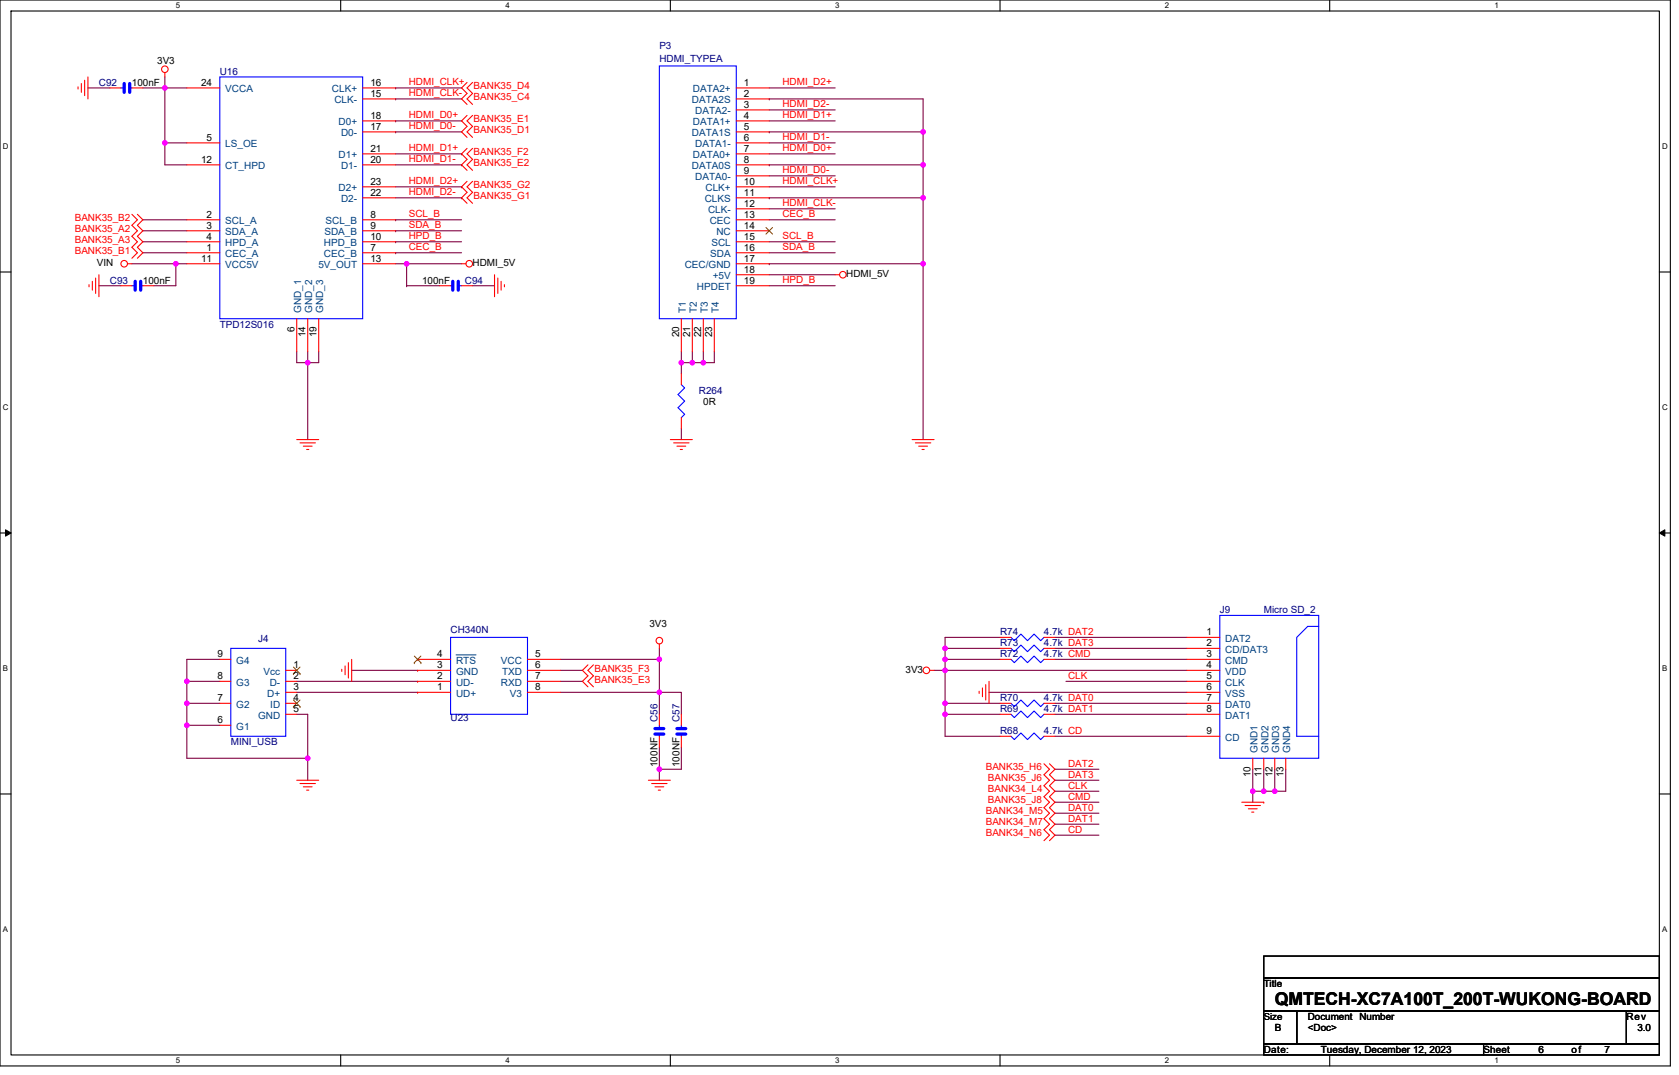
[picture p55: page 6]

D | D

U1I
